L31N/lsd/README.txt

Enthält die LSD Projektdateien von Gruppe 1
