L31N/lsd/reichelt/regel.pdf

reichelt elektronik GmbH & Co. KG * Elektronikring 1 * 26452 Sande

Referenznummer: 4872969417 UNIVERSITÃ„T KARLSRUHE

76131 KARLSRUHE

reichelt elektronik GmbH & Co. KG Elektronikring 1
26452 Sande

Tel.: +49 (0)4422 955-333
Fax.: +49 (0)4422 955-111
www.reichelt.de

Datum: 02.10.2018

Online-Angebot vom 02.10.2018

Artikel-Nr. | Bezeichnung | WG Menge | Einzelpreis
incl. MwSt.

Gesamtpreis
incl. MwSt.
BS 170 | MOSFET, N-CH, 60V, 0,5A, 0,35W, TO-92 | 1 | 8 | 0,10 € | 0,80 €
D-SUB BU 09EU | D-SUB-Buchse, 9-polig, gewinkelt, RM 9,4 | 1 | 1 | 0,40 € | 0,40 €
WSL 10G | Wannenstecker, 10-polig, gerade | 1 | 2 | 0,10 € | 0,20 €
RND 135-00014 | LED, 3 mm, bedrahtet, blau, 3500 mcd, 30Â° | 1 | 8 | 0,090 € | 0,72 €
RND 135-00009 | LED, 3 mm, bedrahtet, grÃ¼n, 15000 mcd, 25Â° | 1 | 3 | 0,090 € | 0,27 €
LF33ABV | LDO-Spannungsregler 3.3 V TO-220 | 1 | 1 | 0,88 € | 0,88 €
16,0000-HC18 | Standardquarz, Grundton, 16,000000 MHz | 1 | 1 | 0,29 € | 0,29 €
1/4W 240 | Widerstand, Kohleschicht, 240 Ohm, 0207, 250 mW, 5% | 1 | 11 | 0,033 € | 0,37 €
1/4W 10K | Widerstand, Kohleschicht, 10 kOhm, 0207, 250 mW, 5% | 1 | 3 | 0,10 € | 0,31 €
X7R-5 100N | Vielschicht-Keramikkondensator 100N, 10% | 1 | 13 | 0,050 € | 0,65 €
RAD 1/63 | Elko, radial, 1,0 ÂµF, 63 V, RM 2,0, 85Â°C, 2000h, 20% | 1 | 4 | 0,020 € | 0,08 €
M-A 1000U 16 | Elko, radial, 1000 ÂµF, 16 V, RM 5, 85Â°C, 2000 h, 20% | 1 | 1 | 0,23 € | 0,23 €
KERKO-500 15P | Keramik-Kondensator, 500V, 15P | 1 | 2 | 0,070 € | 0,14 €
ATMEGA 32L8 DIP | ATMega AVR-RISC-Controller, DIL -40 | 0 | 1 | 6,25 € | 6,25 €
MAX 232 CPE | RS232-Driver, DIL-16 | 1 | 1 | 0,39 € | 0,39 €
WSL 6W | Wannenstecker, 6-polig, gewinkelt | 1 | 1 | 0,24 € | 0,24 €
WSL 14W | Wannenstecker, 14-polig, gewinkelt | 1 | 1 | 0,21 € | 0,21 €
BKL 10120182 | Stiftleiste 36 polig, vergoldet, 2,54mm | 1 | 1 | 0,50 € | 0,50 €
GS 16P | IC-Sockel, 16-polig, superflach, gedreht, vergold. | 1 | 1 | 0,23 € | 0,23 €
MPE 001-2-040-6 | PrÃ¤zisionsfassung, 40 polig, RM 2,54 | 1 | 1 | 0,86 € | 0,86 €
Warenwert | 14,02 € ============ Zuzüglich Versandkosten innerhalb Deutschlands für ca. 0,1 kg | 5,60 €

Alle Preise in Euro inklusive gesetzl. Mehrwertsteuer. Das Angebot wurde im Online-Shop durch den Benutzer selbst aus dem Warenkorb automatisch erstellt und ist freibleibend, Irrtümer und Zwischenverkauf vorbehalten. Zahlbar ohne Abzug, sofort netto Kasse. Angebotsgültigkeit 2 Werktage. Aufgrund der derzeitigen angespannten Liefersituation für Festplatten werden diese zu dem beim Bestelleingang gültigen Tagespreis ausgeliefert (siehe OnlineShop). Bitte geben Sie bei der Bestellung die o. a. Referenznummer an.

Mit freundlichen Grüßen
Ihr reichelt elektronik Team
Notebook, PC ZubehÃ¶r, Festplatte und Elektronik bei Reichelt | https://www.reichelt.de/index.html?IW=1;ACTION=515;SID=95W...
1 von 1 | 02.10.2018, 15:35
