L31N/lsd/reichelt/angebot_display.pdf

## reichelt elektronik GmbH & Co. KG * Elektronikring 1 * 26452 Sande

Referenznummer: 3936603141
UNIVERSITÃT KARLSRUHE
76131 KARLSRUHE

reichelt elektronik GmbH & Co. KG Elektronikring 1
26452 Sande

Tel.: +49 (0)4422 955-333
Fax.: +49 (0)4422 955-111
www.reichelt.de

Datum: 01.10.2018

## Online-Angebot vom 01.10.2018

Artikel-Nr. | Bezeichnung | WG | Menge | Einzelpreis incl. MwSt. | Gesamtpreis incl. MwSt.
LED EL 3-3200GE | LED, 3 mm, bedrahtet, gelb, 3200 mcd, 20° | 1 | 1 | 0,20 € | 0,20 €
LED 3-3700 BL | LED, 3 mm, bedrahtet, blau, 3700 mcd, 20° | 1 | 1 | 0,23 € | 0,23 €
LED 3-4500 RT | LED, 3 mm, bedrahtet, rot, 4500 mcd, 34° | 1 | 1 | 0,29 € | 0,29 €
16,0000-HC49U-S | Standardquarz, Grundton, 16,000000 MHz | 1 | 1 | 0,22 € | 0,22 €
LED 3-9000 GN | LED, 3 mm, bedrahtet, grün, 9000 mcd, 34° | 1 | 1 | 0,32 € | 0,32 €
KERKO 100N | Keramik-Kondensator 100N | 1 | 2 | 0,040 € | 0,08 €
KERKO 15P | Keramik-Kondensator 15P | 1 | 2 | 0,060 € | 0,12 €
PIH PT10MV103IPM | Trimmpotentiometer, 10 kOhm, linear | 1 | 1 | 0,29 € | 0,29 €
ATMEGA 8A-PU | ATMega AVR-RISC-Controller, DIL-28 | 0 | 1 | 1,40 € | 1,40 €
D-SUB BU 09EU | D-SUB-Buchse, 9-polig, gewinkelt, RM 9,4 | 1 | 1 | 0,40 € | 0,40 €
RAD 1/100 | Elko, radial, 1,0 µF, 100 V, RM 2,0, 85°C, 2000h, 20% | 1 | 4 | 0,020 € | 0,08 €
TASTER 3301B | Kurzhubtaster 6x6mm, Höhe: 9,5mm, 12V, vertikal | 1 | 8 | 0,13 € | 1,04 €
PCF 8574 AN | I2C GPIO Expander 100kHz 6V 16-Pin PDIP | 1 | 4 | 1,20 € | 4,80 €
LED 5-39000 GN | LED, 5 mm, bedrahtet, grün, 39000 mcd, 15° | 1 | 12 | 0,23 € | 2,76 €
LED 5-11000 RT | LED, 5 mm, bedrahtet, rot, 11000 mcd, 20° | 1 | 4 | 0,33 € | 1,32 €
RND 135-00030 | LED, 5 mm, bedrahtet, gelb, 20000 mcd , 15° | 1 | 8 | 0,12 € | 0,96 €
K-O SFCN1000T52 | Widerstand, Metallschicht, 100 Ohm, 0207, 0,6 W, 1% | 1 | 22 | 0,048 € | 1,05 €
K-O SFCN1002T52 | Widerstand, Metallschicht, 10 kOhm, 0207, 0,6 W, 1% | 1 | 6 | 0,080 € | 0,48 €
K-O SFCN1500T52 | Widerstand, Metallschicht, 150 Ohm, 0207, 0,6 W, 1% | 1 | 5 | 0,080 € | 0,40 €
K-O SFCN1001T52 | Widerstand, Metallschicht, 1,0 kOhm, 0207, 0,6 W, 1% | 1 | 1 | 0,080 € | 0,08 €
YAG FTE52-220R | Widerstand, Metallschicht, 220 Ohm, 0204, 0,4 W, 1% | 1 | 1 | 0,080 € | 0,08 €
K-O SFCN2201T52 | Widerstand, Metallschicht, 2,2 kOhm, 0207, 0,6 W, 1% | 1 | 1 | 0,080 € | 0,08 €
K-O SFCN47R0T52 | Widerstand, Metallschicht, 47 Ohm, 0207, 0,6 W, 1% | 1 | 1 | 0,080 € | 0,08 €
K-O SFCN4701T52 | Widerstand, Metallschicht, 4,7 kOhm, 0207, 0,6 W, 1% | 1 | 2 | 0,080 € | 0,16 €
MAX 232 CPE | RS232-Driver, DIL-16 | 1 | 1 | 0,39 € | 0,39 €
WL 2X05G 2,00 | 2x5pol. Wannen-Steckerleiste, gerade, RM 2,00 | 1 | 1 | 0,28 € | 0,28 €
Warenwert | | 17,57 €
| ============
Zuzüglich Versandkosten innerhalb Deutschlands für ca. 0,1 kg | | 5,60 €

* * *
1

Alle Preise in Euro inklusive gesetzl. Mehrwertsteuer. Das Angebot wurde im Online-Shop durch den Benutzer selbst aus dem Warenkorb automatisch erstellt und ist freibleibend, Irrtümer und Zwischenverkauf vorbehalten. Zahlbar ohne Abzug, sofort netto Kasse. Angebotsgültigkeit 2 Werktage. Aufgrund der derzeitigen angespannten Liefersituation für Festplatten werden diese zu dem beim Bestelleingang gültigen Tagespreis ausgeliefert (siehe OnlineShop). Bitte geben Sie bei der Bestellung die o. a. Referenznummer an.

Mit freundlichen Grüßen
Ihr reichelt elektronik Team

* * *
2
