L31N/lsd/concept/Konzept-Leistungsplatine.png

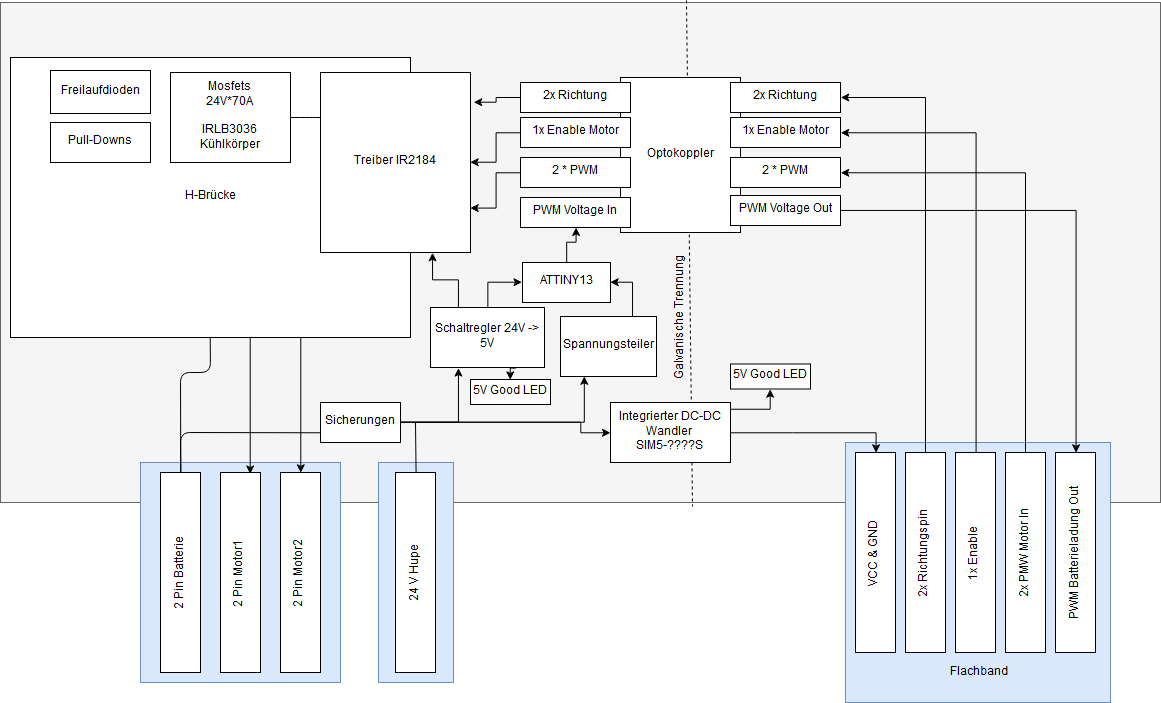
concept/Konzept-Leistungsplatine.png
