L31N/lsd/concept/Konzept-Regelungsplatine.png

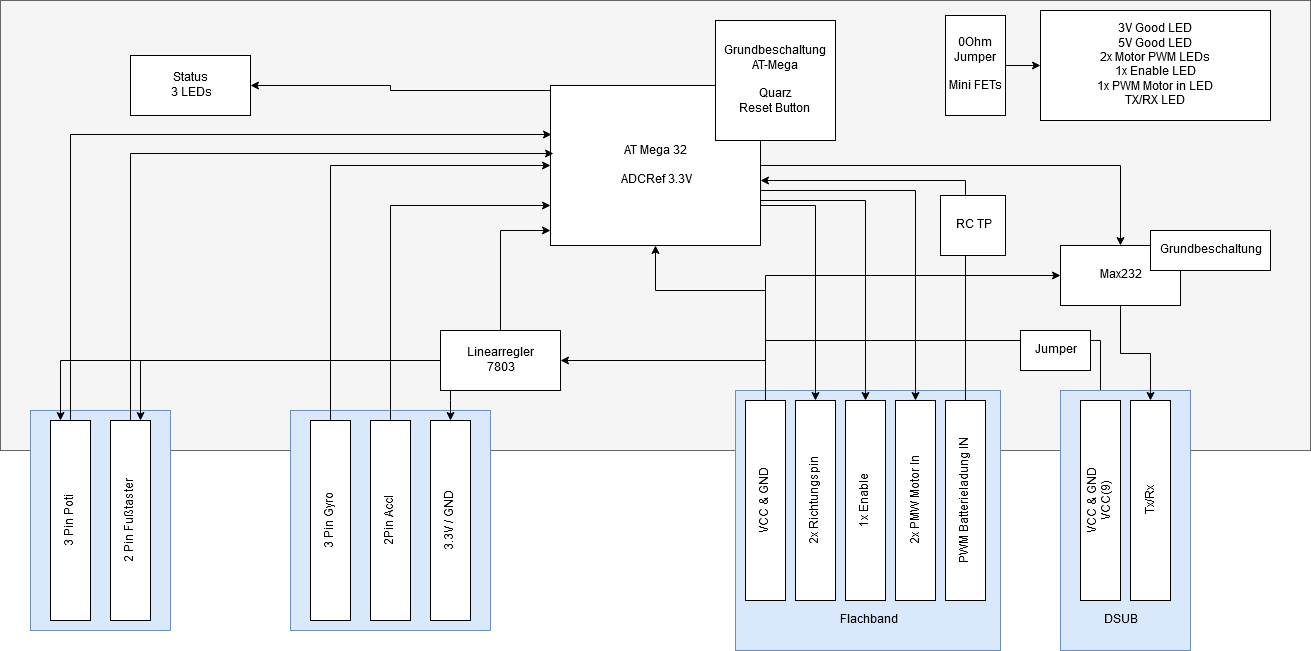
concept/Konzept-Regelungsplatine.png
