L31N/lsd/concept/Kozept-Displayplatine.png

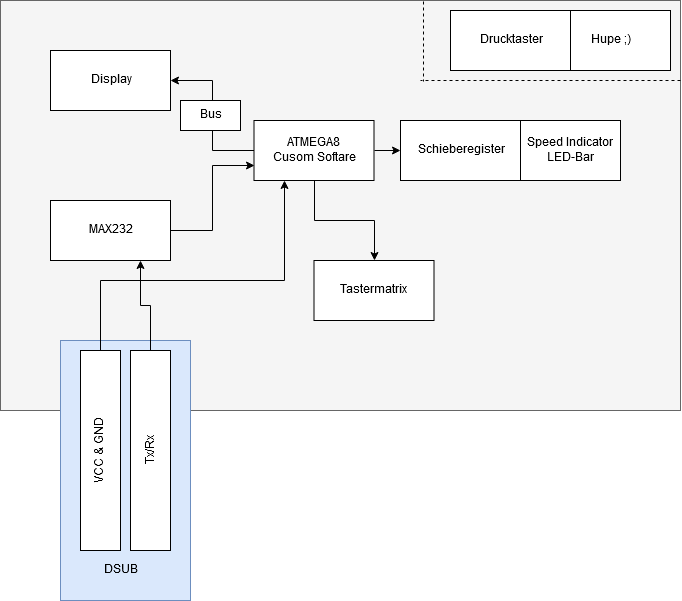
concept/Kozept-Displayplatine.png
