L31N/lsd/datasheets/LC204VL_Pins.jpg

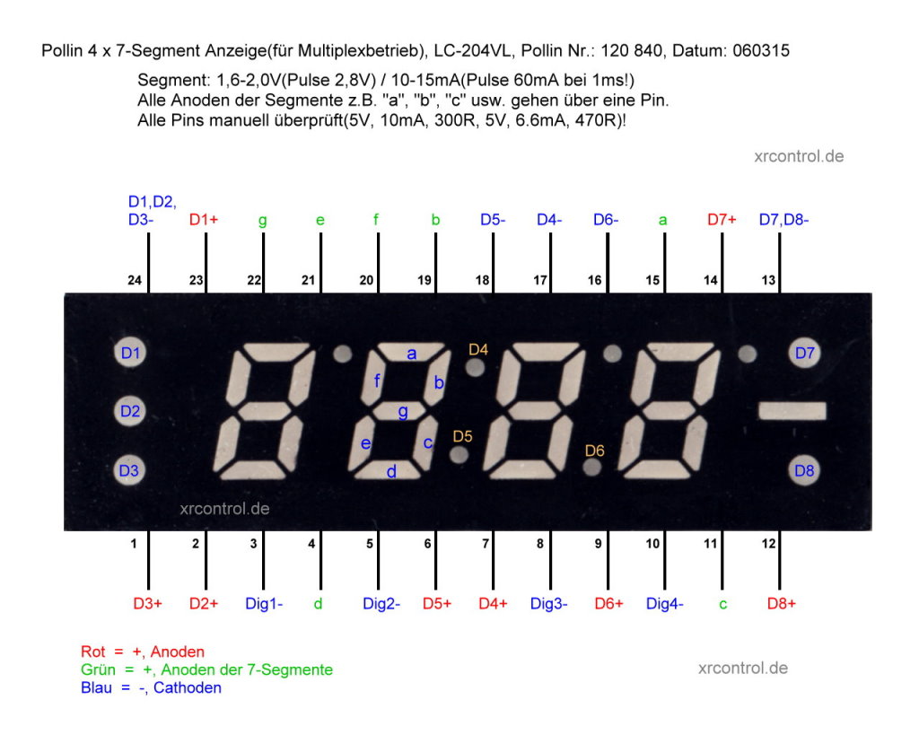
datasheets/LC204VL_Pins.jpg
