L31N/lsd/LSDTivSegG1/display.ods

Part | Value | Device | Package | Library | Sheet | Ordered | Art. Nr.
S1 | 10-XX | B3F-10XX | switch-omron | 6 |  | Y
S2 | 10-XX | B3F-10XX | switch-omron | 6 |  | Y
S3 | 10-XX | B3F-10XX | switch-omron | 6 |  | Y
S4 | 10-XX | B3F-10XX | switch-omron | 6 |  | Y
S5 | 10-XX | B3F-10XX | switch-omron | 6 |  | Y
S6 | 10-XX | B3F-10XX | switch-omron | 6 |  | Y
S7 | 10-XX | B3F-10XX | switch-omron | 6 |  | Y
S8 | 10-XX | B3F-10XX | switch-omron | 6 |  | Y
C1 | 100n | C-EU025-025X050 | C025-025X050 | rcl | 1 | Y
C8 | 100n | C-EU025-025X050 | C025-025X050 | rcl | 1 | Y
R12 | 100R | R-EU_0207/10 | 0207/10 | rcl | 5 | Y
R13 | 100R | R-EU_0207/10 | 0207/10 | rcl | 5 | Y
R14 | 100R | R-EU_0207/10 | 0207/10 | rcl | 5 | Y
R15 | 100R | R-EU_0207/10 | 0207/10 | rcl | 5 | Y
R16 | 100R | R-EU_0207/10 | 0207/10 | rcl | 5 | Y
R17 | 100R | R-EU_0207/10 | 0207/10 | rcl | 5 | Y
R18 | 100R | R-EU_0207/10 | 0207/10 | rcl | 5 | Y
R19 | 100R | R-EU_0207/10 | 0207/10 | rcl | 5 | Y
R20 | 100R | R-EU_0207/10 | 0207/10 | rcl | 5 | Y
R21 | 100R | R-EU_0207/10 | 0207/10 | rcl | 5 | Y
R24 | 100R | R-EU_0207/10 | 0207/10 | rcl | 5 | Y
R25 | 100R | R-EU_0207/10 | 0207/10 | rcl | 5 | Y
R26 | 100R | R-EU_0207/10 | 0207/10 | rcl | 5 | Y
R27 | 100R | R-EU_0207/10 | 0207/10 | rcl | 5 | Y
R28 | 100R | R-EU_0207/10 | 0207/10 | rcl | 5 | Y
R29 | 100R | R-EU_0207/10 | 0207/10 | rcl | 5 | Y
R30 | 100R | R-EU_0207/10 | 0207/10 | rcl | 5 | Y
R31 | 100R | R-EU_0207/10 | 0207/10 | rcl | 5 | Y
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
LED21 | yellow | LED5MM | LED5MM | led | 5 | Y
LED22 | yellow | LED5MM | LED5MM | led | 5 | Y
LED27 | yellow | LED3MM | LED3MM | led | 1 | Y
LED7 | yellow | LED5MM | LED5MM | led | 5 | Y
LED8 | yellow | LED5MM | LED5MM | led | 5 | Y
LED9 | yellow | LED5MM | LED5MM | led | 5 | Y
