L31N/lsd/LSDTivSegG1/leistung.pdf

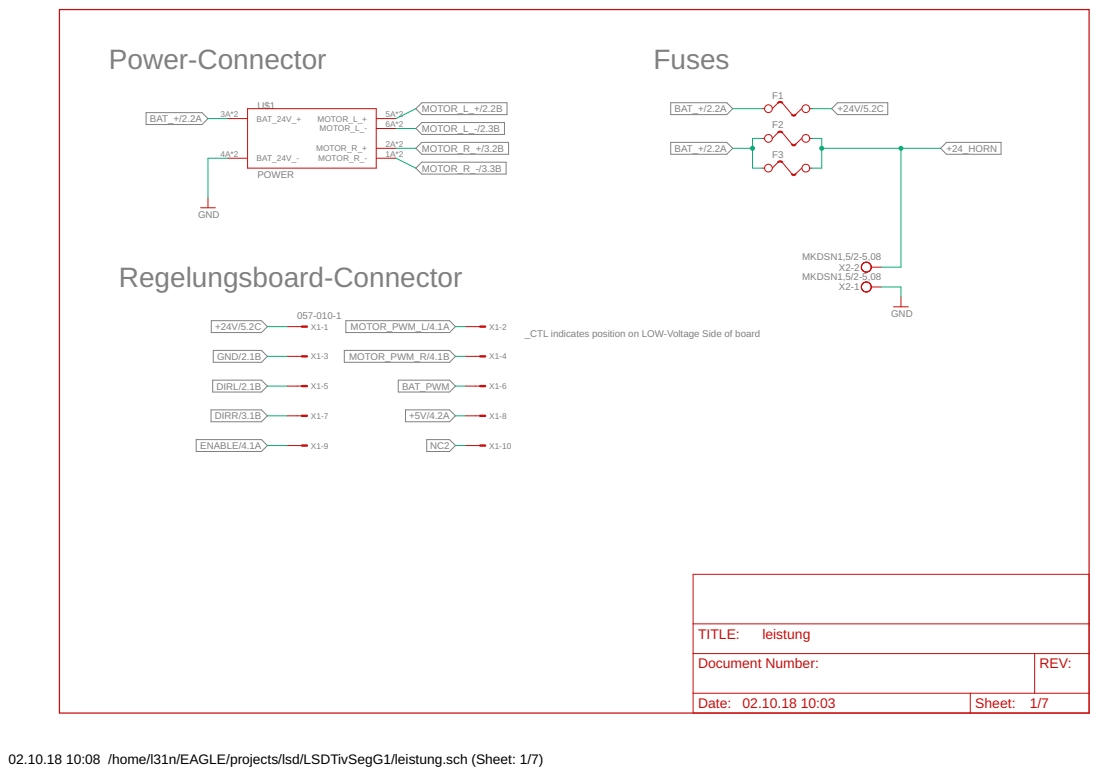
[picture p5: page 1]

_CTL indicates position on LOW-Voltage Side of board

Document Number: | REV:

Date: 02.10.18 10:03 | Sheet: 1/7

02.10.18 10:08 /home/l31n/EAGLE/projects/lsd/LSDTivSegG1/leistung.sch (Sheet: 1/7)

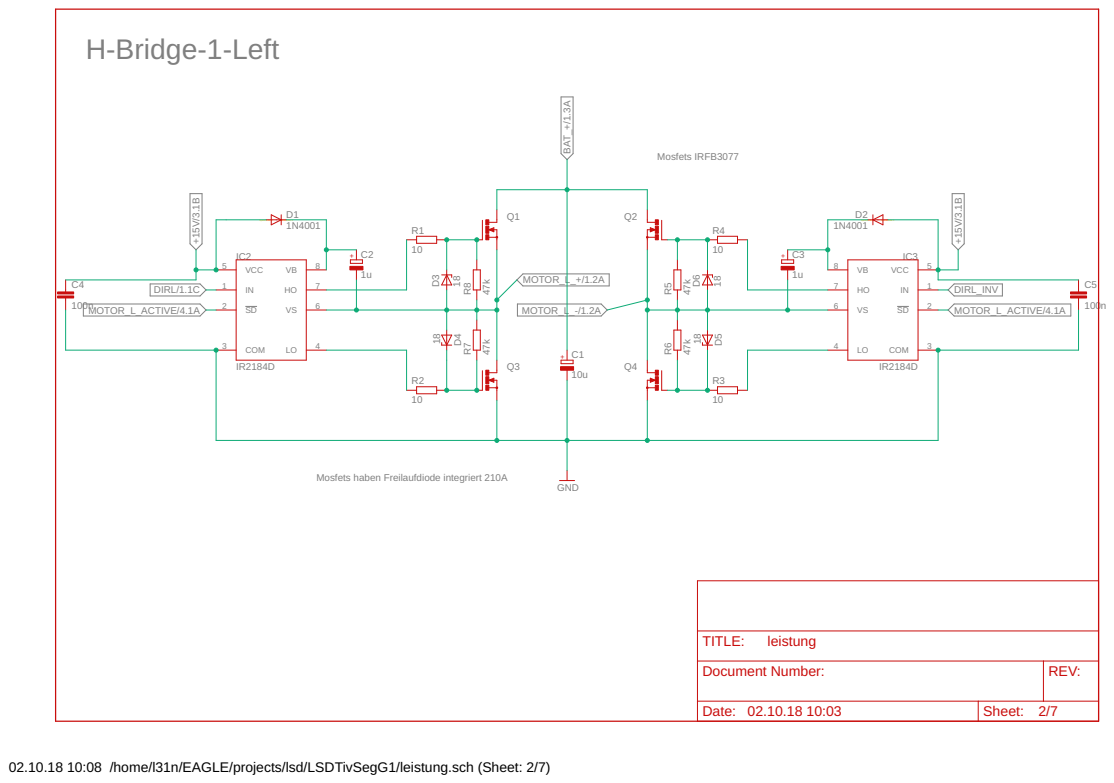
[picture p6: page 2]

Mosfets haben Freilaufdiode integriert 210A

Document Number: | REV:

Date: 02.10.18 10:03 | Sheet: 2/7

02.10.18 10:08 /home/l31n/EAGLE/projects/lsd/LSDTivSegG1/leistung.sch (Sheet: 2/7)

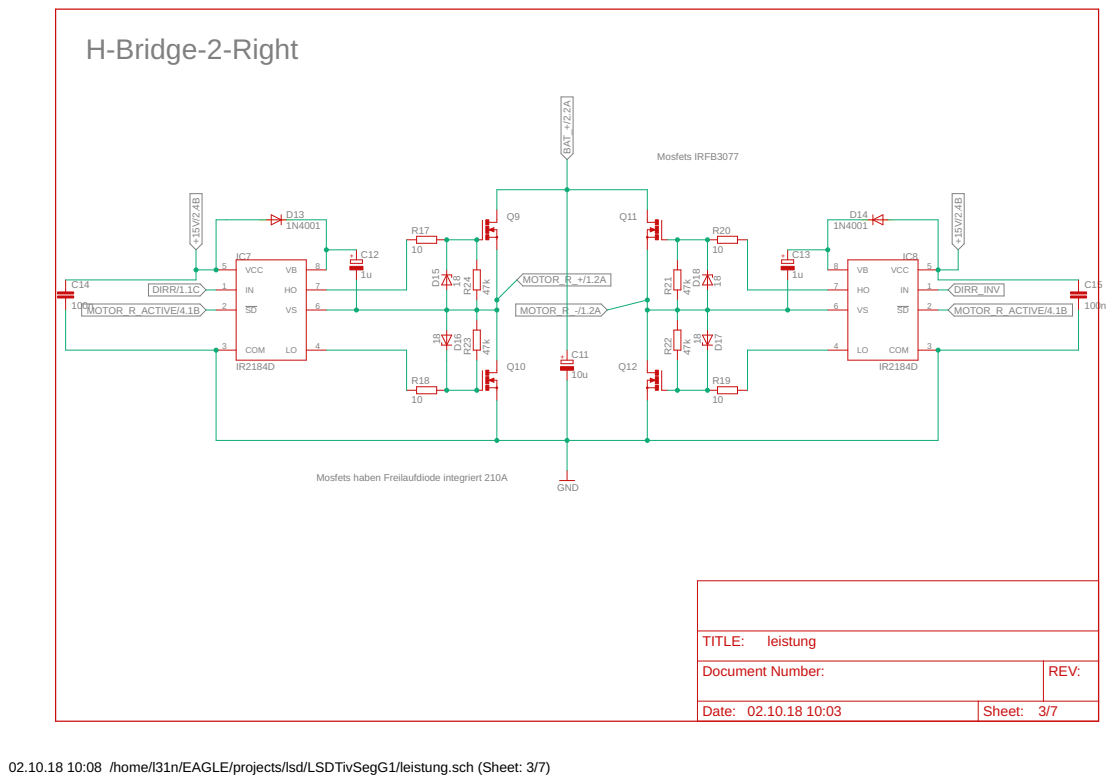
[picture p7: page 3]

Mosfets haben Freilaufdiode integriert 210A

Document Number: | REV:

Date: 02.10.18 10:03 | Sheet: 3/7

02.10.18 10:08 /home/l31n/EAGLE/projects/lsd/LSDTivSegG1/leistung.sch (Sheet: 3/7)

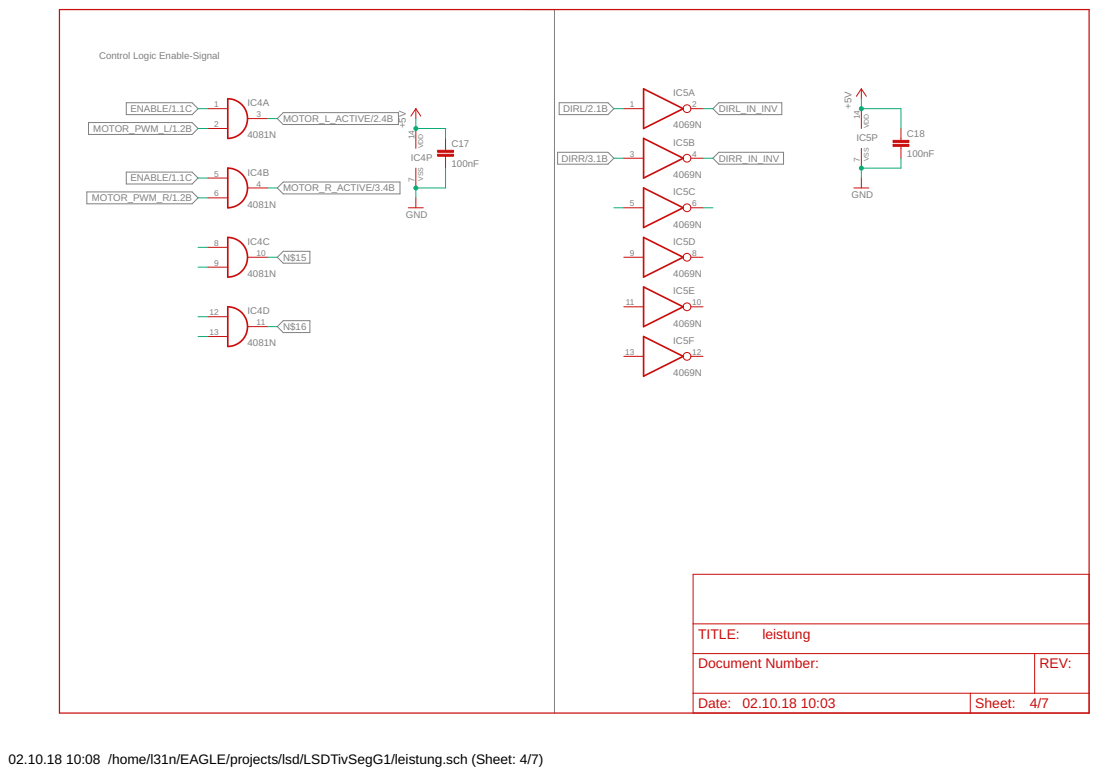
[picture p8: page 4]

Control Logic Enable-Signal

Document Number: | REV:

Date: 02.10.18 10:03 | Sheet: 4/7

02.10.18 10:08 /home/l31n/EAGLE/projects/lsd/LSDTivSegG1/leistung.sch (Sheet: 4/7)

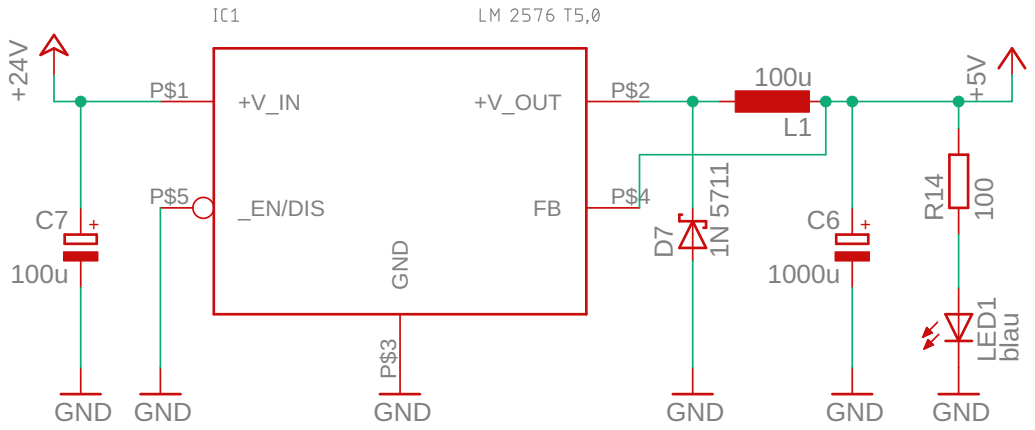
[picture p9: page 5]

02.10.18 10:08 f=0.91 /home/l31n/EAGLE/projects/lsd/LSDTivSegG1/leistung.sch (Sheet: 5/7)

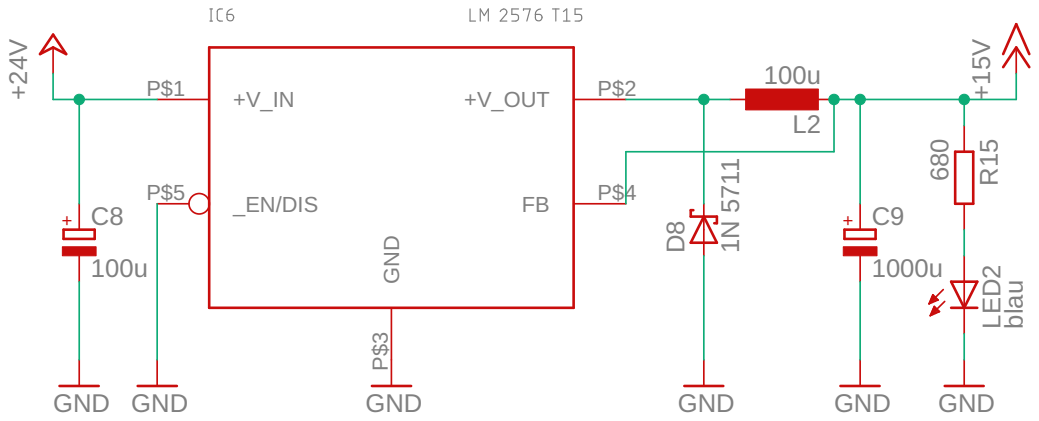
[picture p10: page 6]

02.10.18 10:08 f=0.91 /home/l31n/EAGLE/projects/lsd/LSDTivSegG1/leistung.sch (Sheet: 6/7)

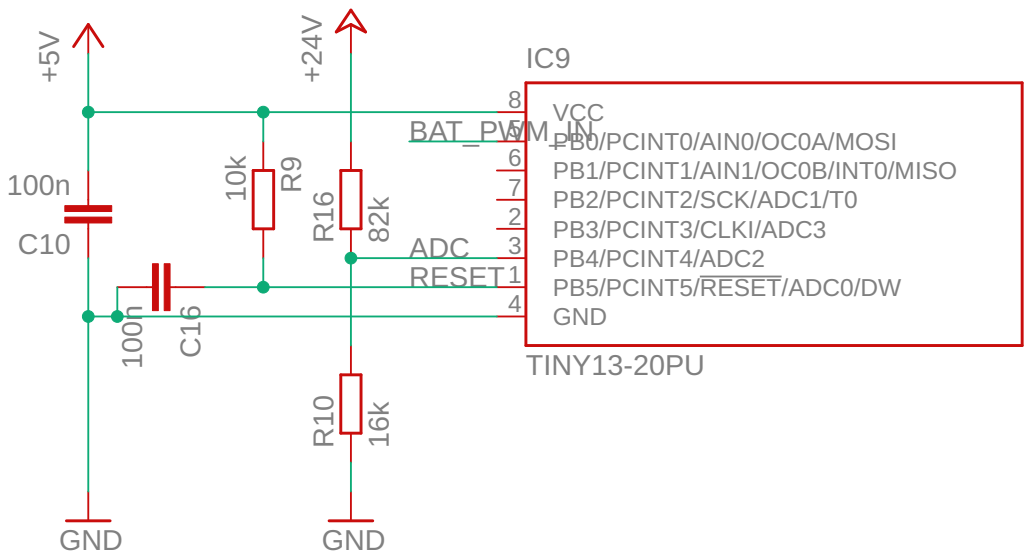
[picture p11: page 7]

02.10.18 10:08 f=0.91 /home/l31n/EAGLE/projects/lsd/LSDTivSegG1/leistung.sch (Sheet: 7/7)
