L31N/lsd/LSDTivSegG1/display_brd_bottom.pdf

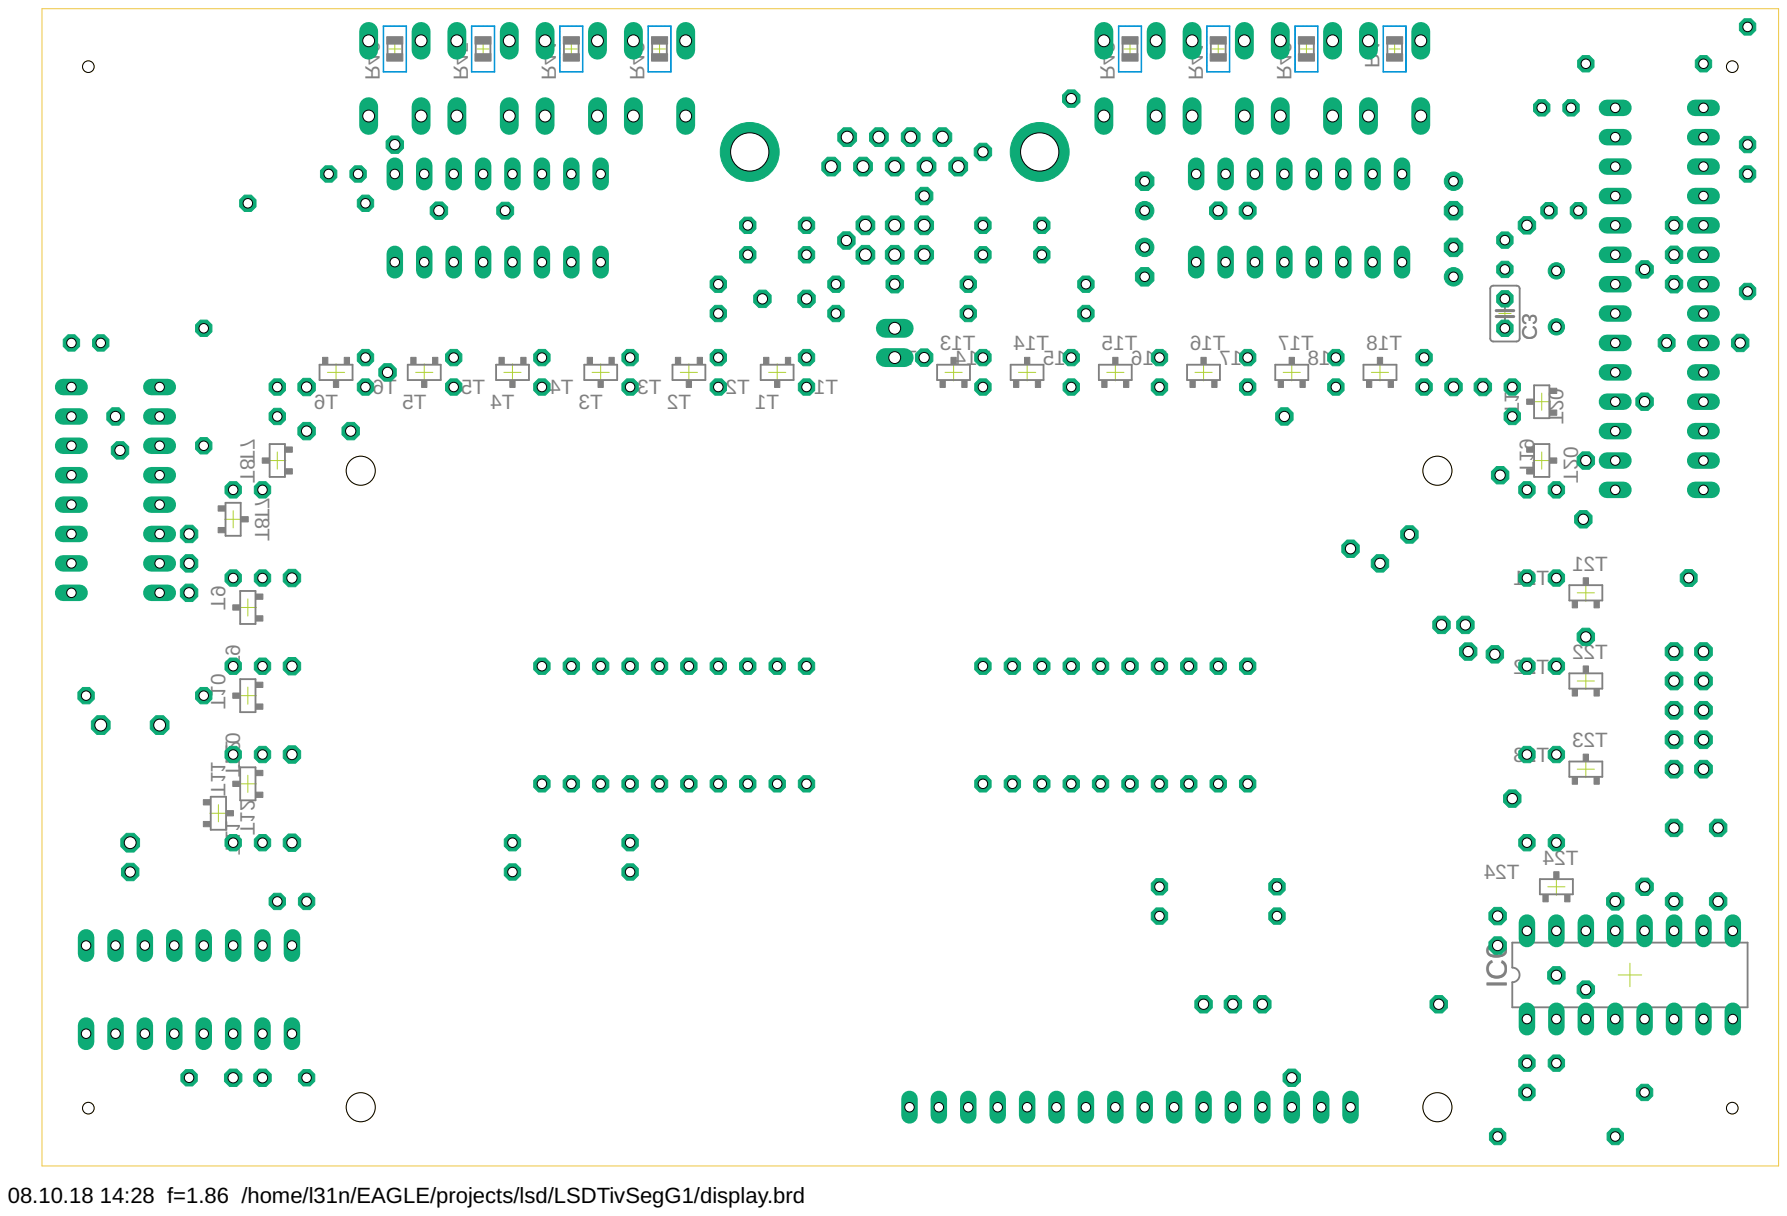
[picture p12: page 1]

08.10.18 14:28 f=1.86 /home/l31n/EAGLE/projects/lsd/LSDTivSegG1/display.brd
