L31N/lsd/LSDTivSegG1/display.pdf

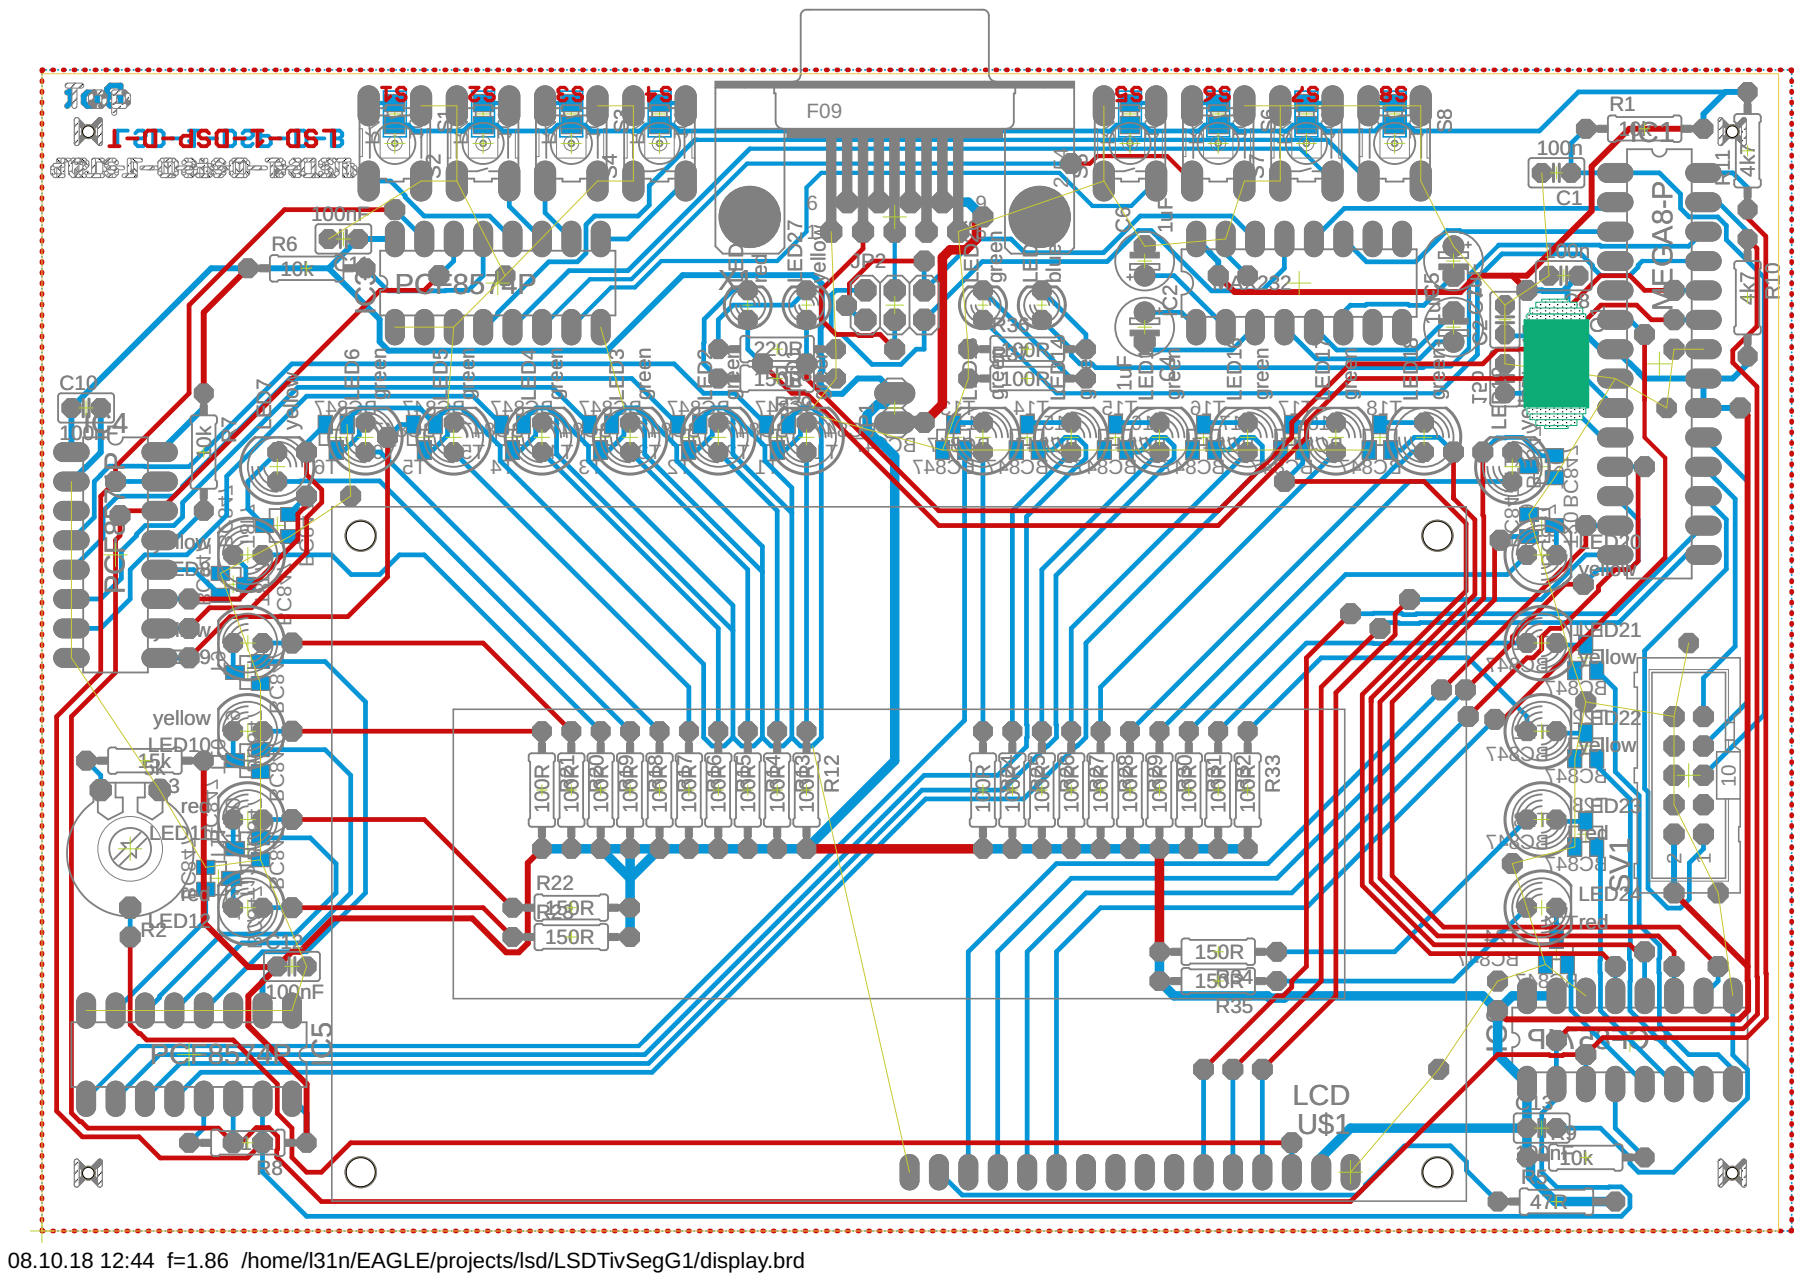
[picture p14: page 1]

08.10.18 12:44 f=1.86 /home/l31n/EAGLE/projects/lsd/LSDTivSegG1/display.brd
