L31N/lsd/LSDTivSegG1/regelschaltplan.pdf

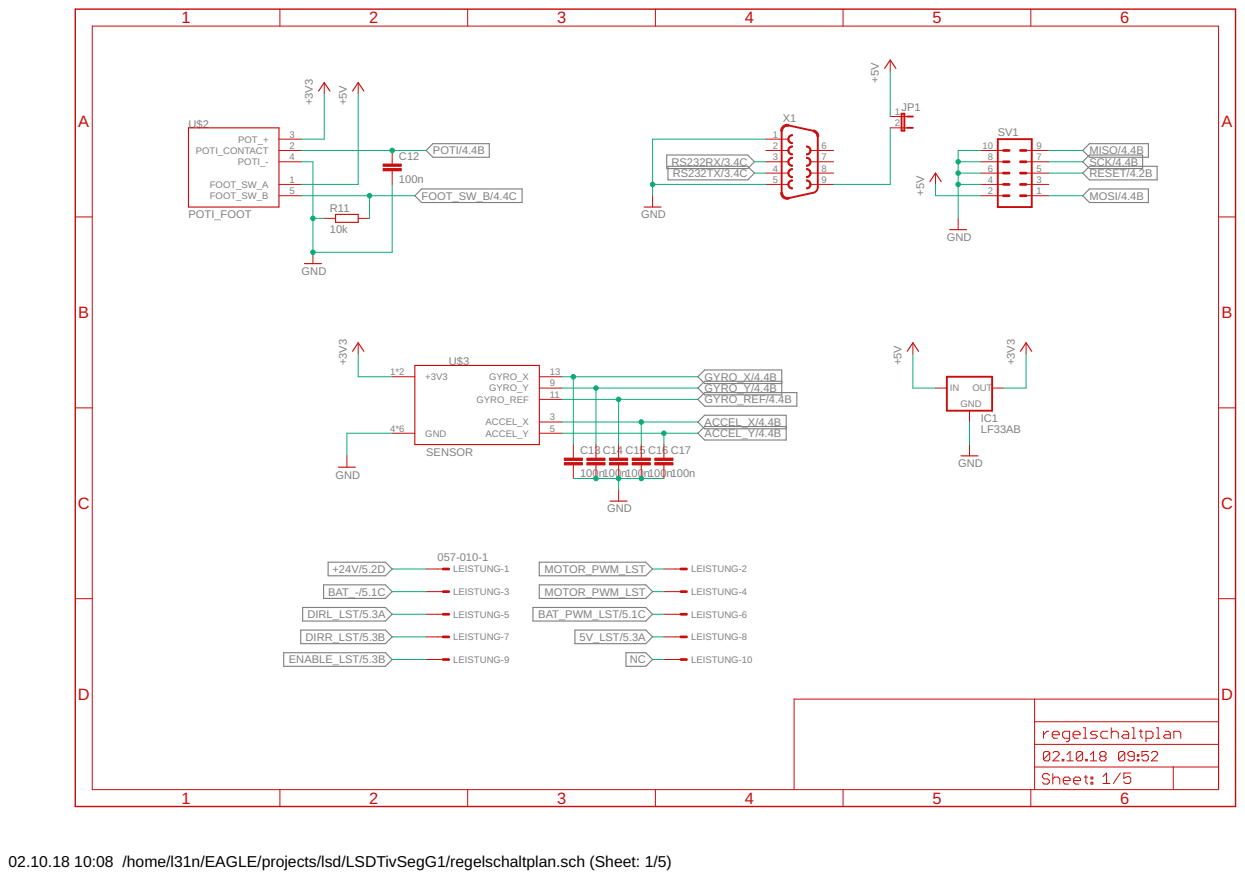
[picture p15: page 1]

02.10.18 10:08 /home/l31n/EAGLE/projects/lsd/LSDTivSegG1/regelschaltplan.sch (Sheet: 1/5)

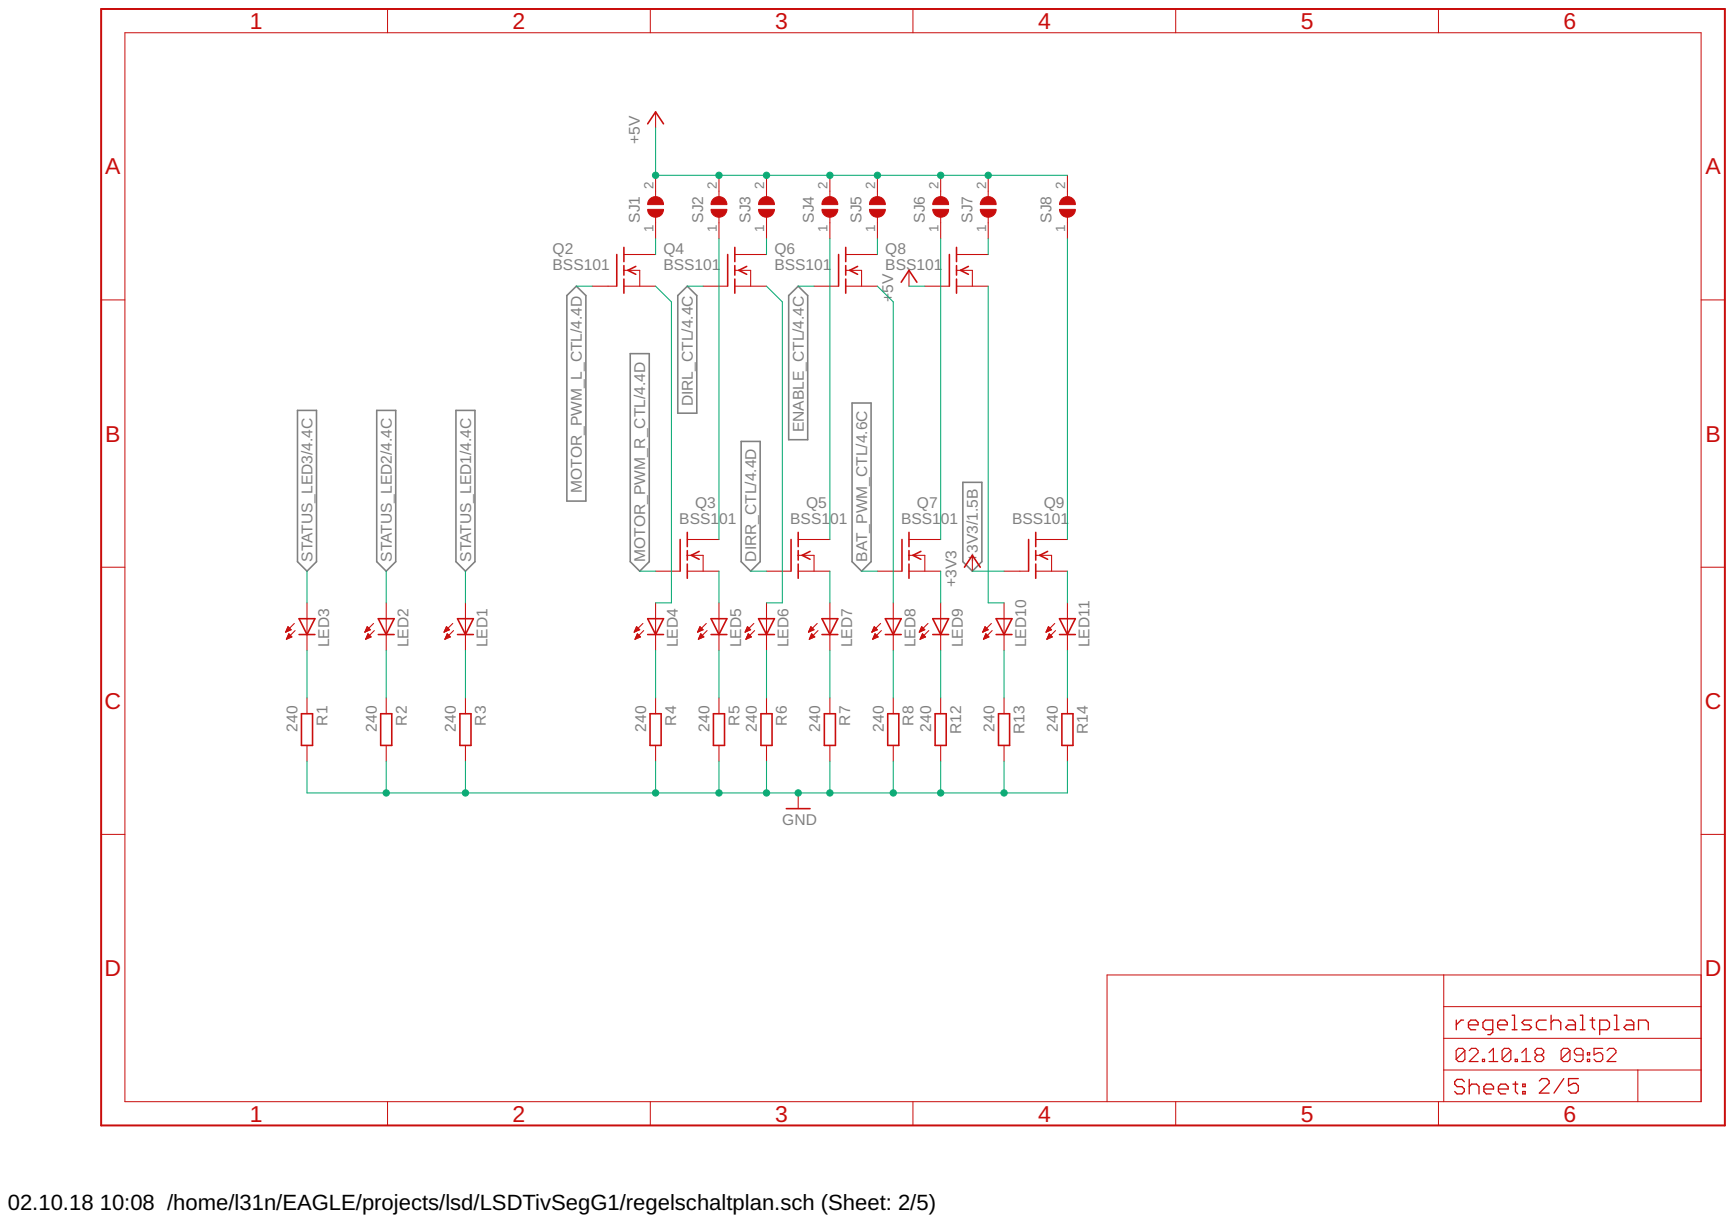
[picture p16: page 2]

02.10.18 10:08 /home/l31n/EAGLE/projects/lsd/LSDTivSegG1/regelschaltplan.sch (Sheet: 2/5)

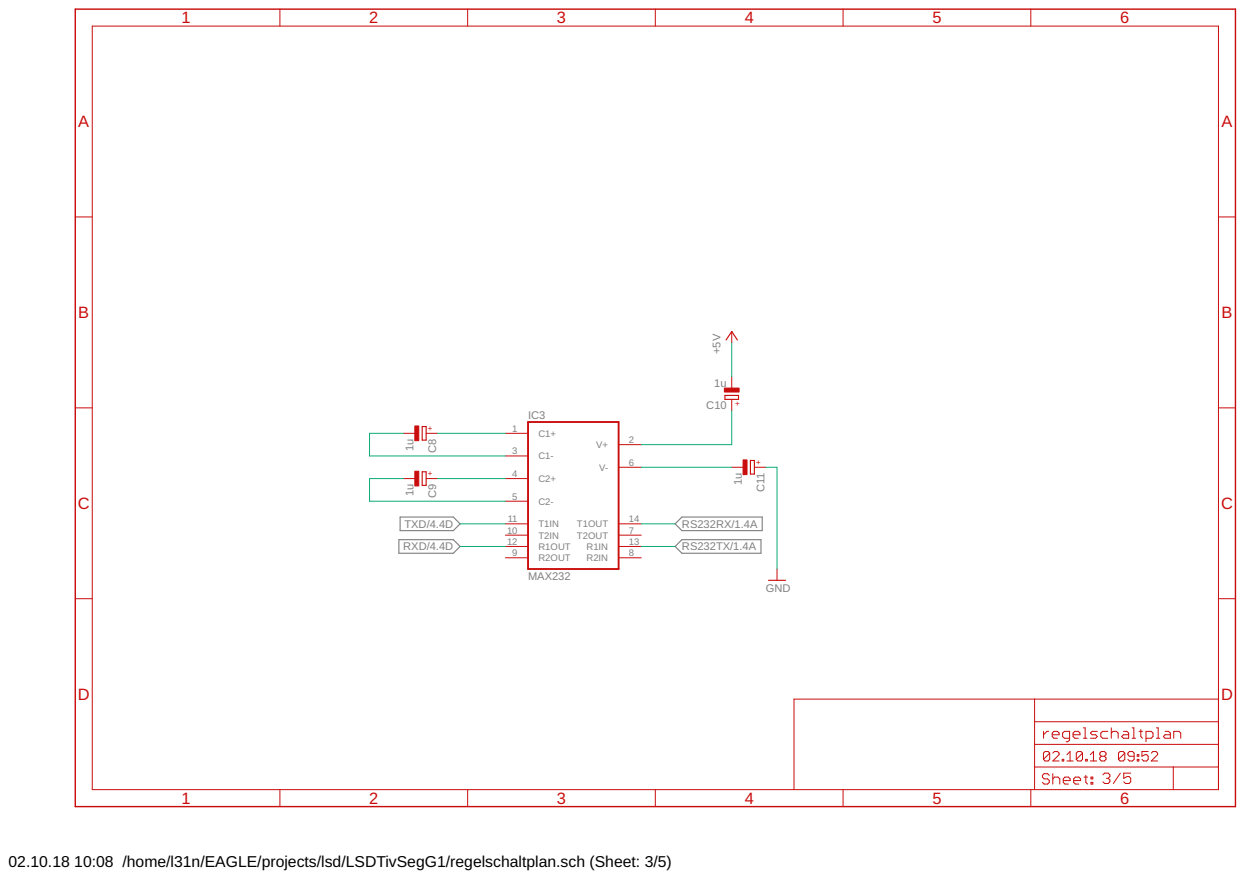
[picture p17: page 3]

02.10.18 10:08 /home/l31n/EAGLE/projects/lsd/LSDTivSegG1/regelschaltplan.sch (Sheet: 3/5)

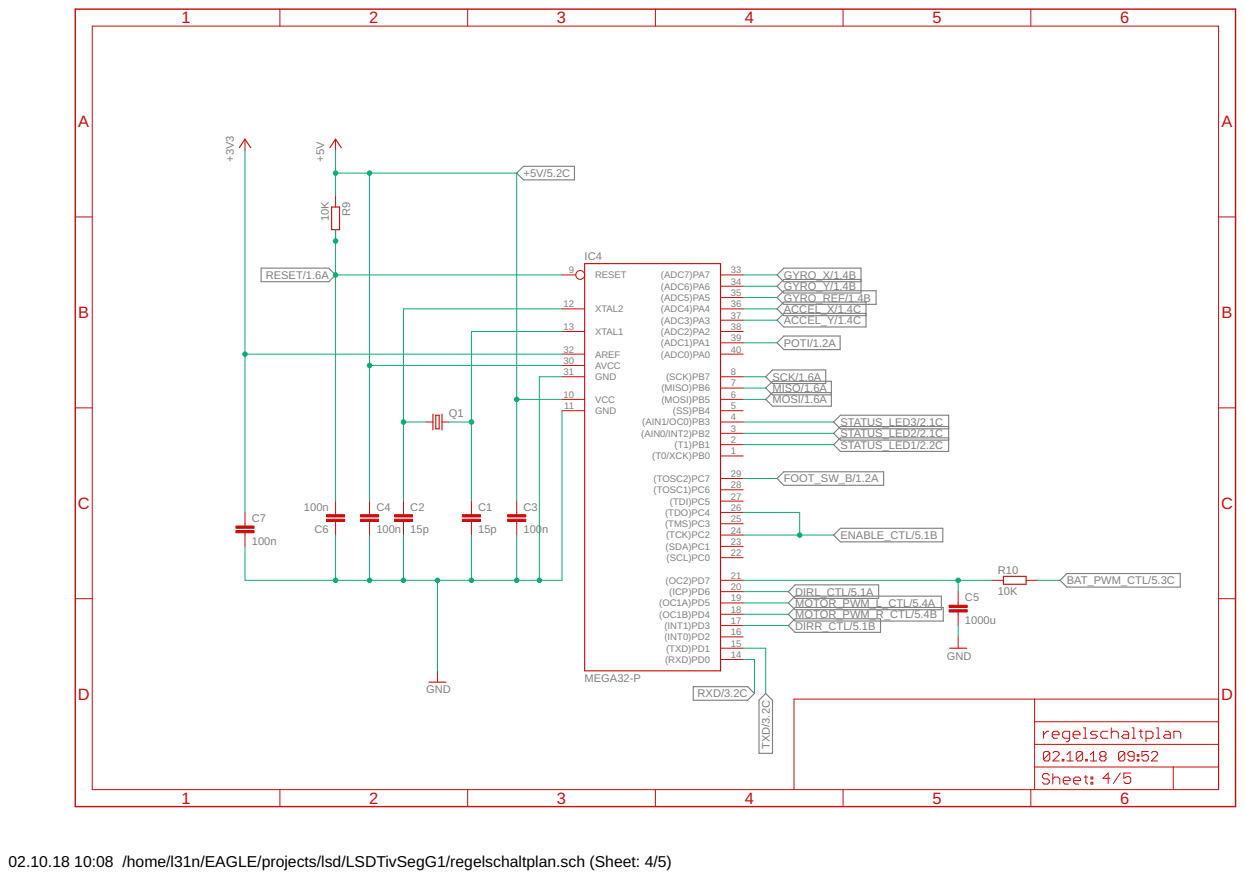
[picture p18: page 4]

02.10.18 10:08 /home/l31n/EAGLE/projects/lsd/LSDTivSegG1/regelschaltplan.sch (Sheet: 4/5)

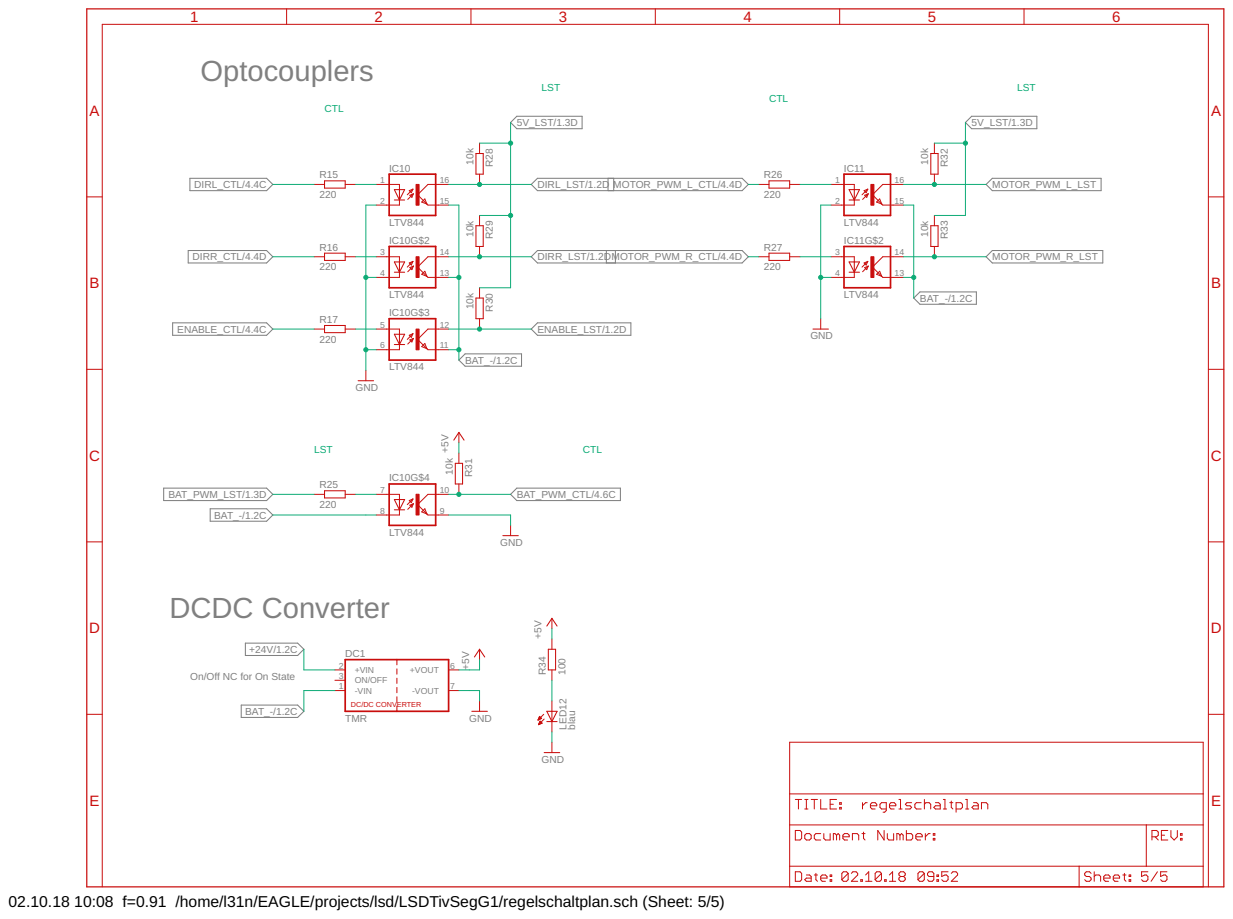
[picture p19: page 5]

On/Off NC for On State

02.10.18 10:08 f=0.91 /home/l31n/EAGLE/projects/lsd/LSDTivSegG1/regelschaltplan.sch (Sheet: 5/5)
