L31N/lsd/LSDTivSegG1/regelschaltplan_e7.brd

## EAGLE design LSDTivSegG1/regelschaltplan_e7.brd (2018-10-08)

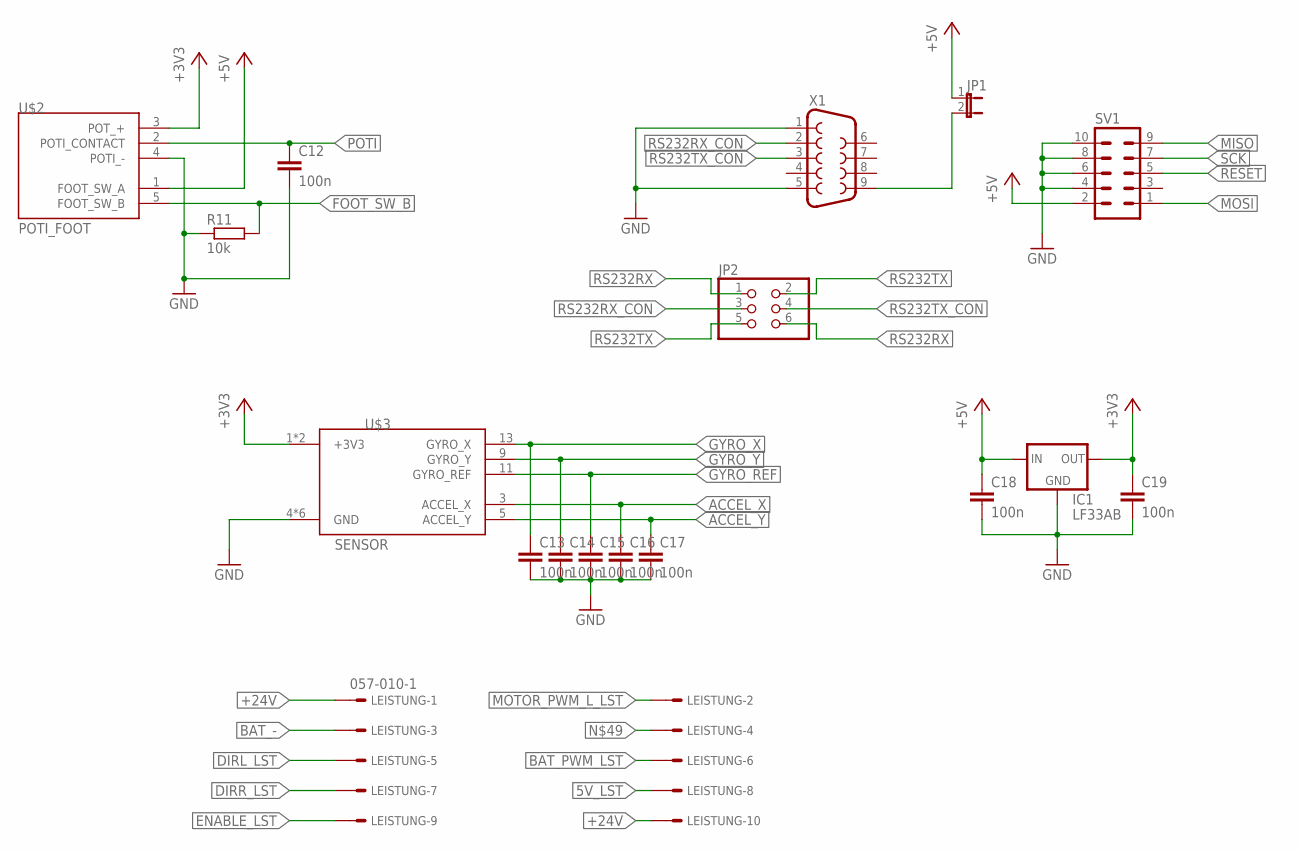
[picture p20: schematic regelschaltplan_e7.sch, sheet 1]

Parts:
C12, C13, C14, C15, C16, C17, C18, C19: 100n; C025-025X050
IC1: LF33AB; TO220
JP1: JP1E; JP1
JP2: PINHD-2X3; 2X03
LEISTUNG: 057-010-1
R11: 10k; 0207/7
SV1: MA05-2
U$2: POTI_FOOT; CON_6
U$3: SENSOR; CON_14
X1: F09HP

Connections:
5V_LST: LEISTUNG.8; also elsewhere on the board
+3V3: C19.1, IC1.3 (OUT), U$2.3 (POT_+), U$3.1 (+3V3), U$3.2 (+3V3); also elsewhere on the board
+24V: LEISTUNG.1, LEISTUNG.10; also elsewhere on the board
ACCEL_X: C16.1, U$3.3 (ACCEL_X); also elsewhere on the board
ACCEL_Y: C17.1, U$3.5 (ACCEL_Y); also elsewhere on the board
BAT_-: LEISTUNG.3; also elsewhere on the board
BAT_PWM_LST: LEISTUNG.6; also elsewhere on the board
DIRL_LST: LEISTUNG.5; also elsewhere on the board
DIRR_LST: LEISTUNG.7; also elsewhere on the board
ENABLE_LST: LEISTUNG.9; also elsewhere on the board
FOOT_SW_B: R11.2, U$2.5 (FOOT_SW_B); also elsewhere on the board
GND: C12.2, C13.2, C14.2, C15.2, C16.2, C17.2, C18.2, C19.2, IC1.2 (GND), R11.1, SV1.4, SV1.6, SV1.8, SV1.10, U$2.4 (POTI_-), U$3.4 (GND), U$3.6 (GND), U$3.8 (GND), U$3.10 (GND), U$3.12 (GND), U$3.14 (GND), X1.1, X1.5; also elsewhere on the board
GYRO_REF: C15.1, U$3.11 (GYRO_REF); also elsewhere on the board
GYRO_X: C13.1, U$3.13 (GYRO_X); also elsewhere on the board
GYRO_Y: C14.1, U$3.9 (GYRO_Y); also elsewhere on the board
MISO: SV1.9; also elsewhere on the board
MOSI: SV1.1; also elsewhere on the board
MOTOR_PWM_L_LST: LEISTUNG.2; also elsewhere on the board
unnamed 58: C18.1, IC1.1 (IN), JP1.1, SV1.2, U$2.1 (FOOT_SW_A); also elsewhere on the board
unnamed: JP1.2, X1.9
unnamed 71: LEISTUNG.4; also elsewhere on the board
POTI: C12.1, U$2.2 (POTI_CONTACT); also elsewhere on the board
RESET: SV1.5; also elsewhere on the board
RS232RX: JP2.1, JP2.6; also elsewhere on the board
RS232RX_CON: JP2.3, X1.2
RS232TX: JP2.2, JP2.5; also elsewhere on the board
RS232TX_CON: JP2.4, X1.3
SCK: SV1.7; also elsewhere on the board

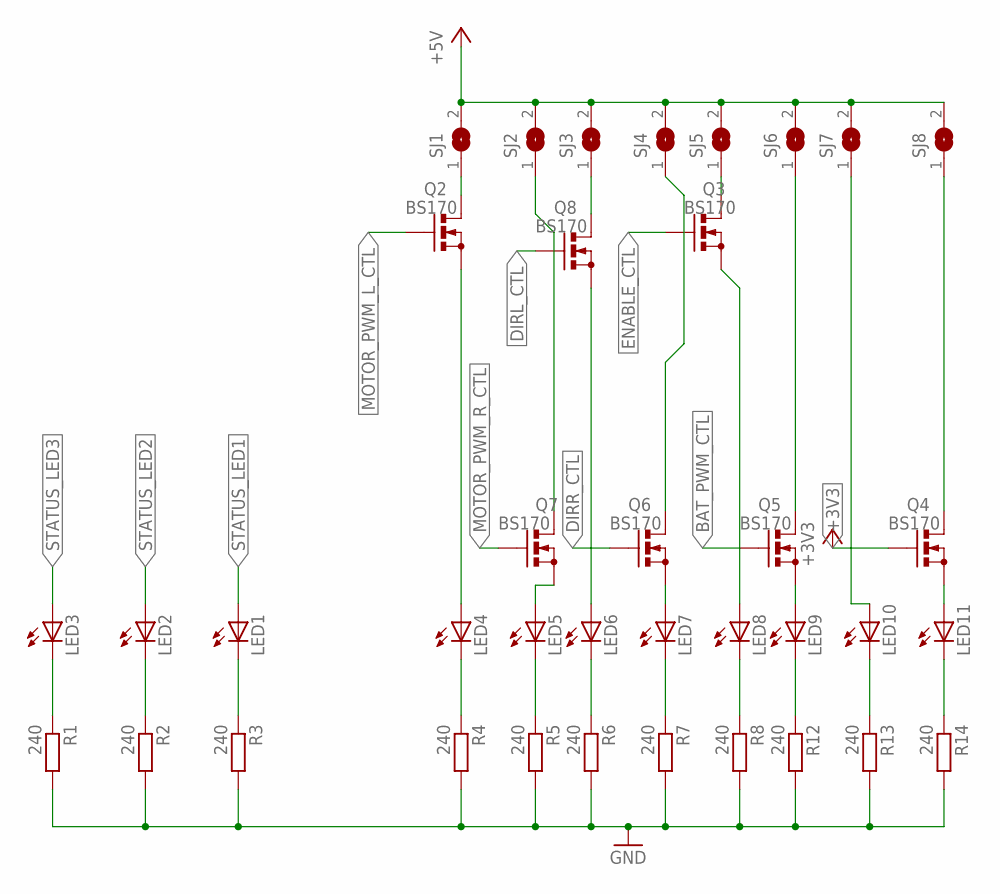
[picture p21: schematic regelschaltplan_e7.sch, sheet 2]

Parts:
LED1, LED2, LED3, LED4, LED5, LED6, LED7, LED8, LED9, LED10, LED11: LED3MM
Q2, Q3, Q4, Q5, Q6, Q7, Q8: BS170; SOT54E
R1, R2, R3, R4, R5, R6, R7, R8, R12, R13, R14: 240; 0207/7
SJ1, SJ2, SJ3, SJ4, SJ5, SJ6, SJ7, SJ8: SJ

Connections:
+3V3: Q4.G; also elsewhere on the board
BAT_PWM_CTL: Q5.G; also elsewhere on the board
DIRL_CTL: Q8.G; also elsewhere on the board
DIRR_CTL: Q6.G; also elsewhere on the board
ENABLE_CTL: Q3.G; also elsewhere on the board
GND: R1.2, R2.2, R3.2, R4.2, R5.2, R6.2, R7.2, R8.2, R12.2, R13.2, R14.2; also elsewhere on the board
MOTOR_PWM_L_CTL: Q2.G; also elsewhere on the board
MOTOR_PWM_R_CTL: Q7.G; also elsewhere on the board
unnamed: Q2.D, SJ1.1
unnamed: LED4.K (C), R4.1
unnamed: LED5.K (C), R5.1
unnamed: LED6.K (C), R6.1
unnamed: LED6.A, Q8.S
unnamed: LED7.K (C), R7.1
unnamed: LED8.K (C), R8.1
unnamed: LED9.K (C), R12.1
unnamed: LED10.K (C), R13.1
unnamed: LED11.K (C), R14.1
unnamed: LED8.A, Q3.S
unnamed: LED10.A, SJ7.1
unnamed: LED9.A, Q5.S
unnamed: Q4.D, SJ8.1
unnamed: LED7.A, Q6.S
unnamed: LED5.A, Q7.S
unnamed: Q7.D, SJ2.1
unnamed: LED4.A, Q2.S
unnamed: LED11.A, Q4.S
unnamed: LED2.K (C), R2.1
unnamed: LED3.K (C), R1.1
unnamed: Q6.D, SJ4.1
unnamed: Q5.D, SJ6.1
unnamed: Q3.D, SJ5.1
unnamed: Q8.D, SJ3.1
unnamed 58: SJ1.2, SJ2.2, SJ3.2, SJ4.2, SJ5.2, SJ6.2, SJ7.2, SJ8.2; also elsewhere on the board
unnamed: LED1.K (C), R3.1
STATUS_LED1: LED1.A; also elsewhere on the board
STATUS_LED2: LED2.A; also elsewhere on the board
STATUS_LED3: LED3.A; also elsewhere on the board

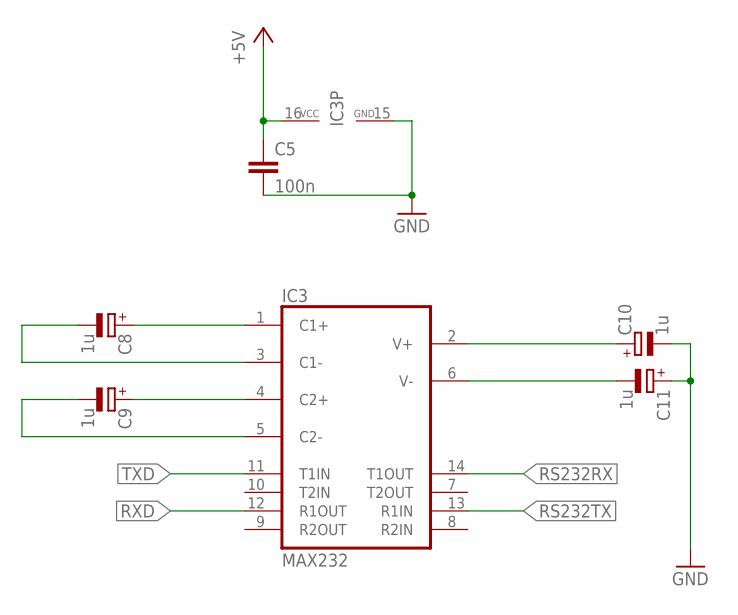
[picture p22: schematic regelschaltplan_e7.sch, sheet 3]

Parts:
C5: 100n; C025-025X050
C8, C9, C10, C11: 1u; E2,5-6E
IC3: MAX232; DIL16

Connections:
GND: C5.2, C10.-, C11.+, IC3.15 (GND); also elsewhere on the board
unnamed: C8.+, IC3.1 (C1+)
unnamed: C8.-, IC3.3 (C1-)
unnamed: C9.+, IC3.4 (C2+)
unnamed: C10.+, IC3.2 (V+)
unnamed: C11.-, IC3.6 (V-)
unnamed 58: C5.1, IC3.16 (VCC); also elsewhere on the board
NS1234: C9.-, IC3.5 (C2-)
RS232RX: IC3.14 (T1OUT); also elsewhere on the board
RS232TX: IC3.13 (R1IN); also elsewhere on the board
RXD: IC3.12 (R1OUT); also elsewhere on the board
TXD: IC3.11 (T1IN); also elsewhere on the board

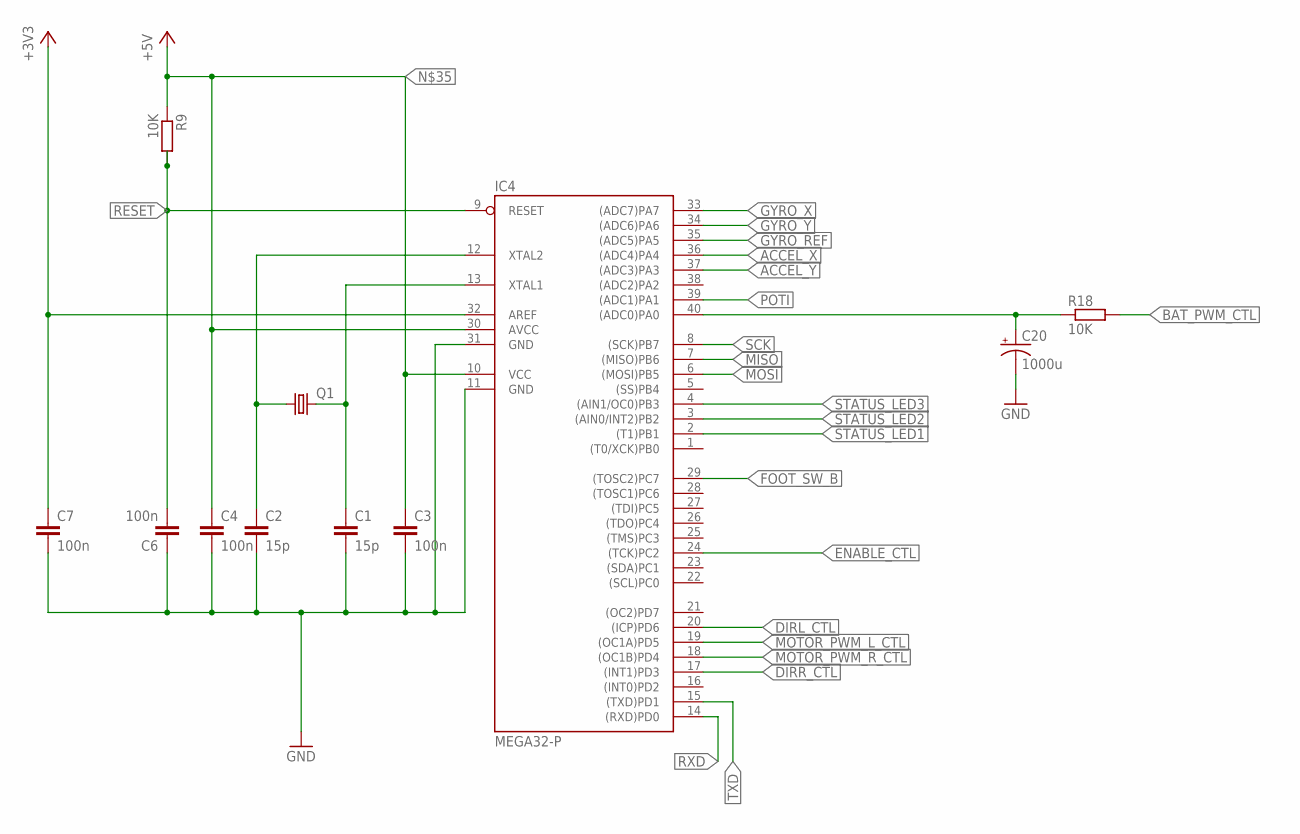
[picture p23: schematic regelschaltplan_e7.sch, sheet 4]

Parts:
C1, C2: 15p; C025-025X050
C3, C4, C6, C7: 100n; C025-025X050
C20: 1000u; E2,5-6E
IC4: MEGA32-P; DIL40
Q1: CRYSTALHC49U-V; HC49U-V
R9, R18: 10K; 0207/7

Connections:
+3V3: C7.1, IC4.32 (AREF); also elsewhere on the board
ACCEL_X: IC4.36 ((ADC4)PA4); also elsewhere on the board
ACCEL_Y: IC4.37 ((ADC3)PA3); also elsewhere on the board
BAT_PWM_CTL: R18.2; also elsewhere on the board
DIRL_CTL: IC4.20 ((ICP)PD6); also elsewhere on the board
DIRR_CTL: IC4.17 ((INT1)PD3); also elsewhere on the board
ENABLE_CTL: IC4.24 ((TCK)PC2); also elsewhere on the board
FOOT_SW_B: IC4.29 ((TOSC2)PC7); also elsewhere on the board
GND: C1.2, C2.2, C3.2, C4.2, C6.1, C7.2, C20.-, IC4.11 (GND), IC4.31 (GND); also elsewhere on the board
GYRO_REF: IC4.35 ((ADC5)PA5); also elsewhere on the board
GYRO_X: IC4.33 ((ADC7)PA7); also elsewhere on the board
GYRO_Y: IC4.34 ((ADC6)PA6); also elsewhere on the board
MISO: IC4.7 ((MISO)PB6); also elsewhere on the board
MOSI: IC4.6 ((MOSI)PB5); also elsewhere on the board
MOTOR_PWM_L_CTL: IC4.19 ((OC1A)PD5); also elsewhere on the board
MOTOR_PWM_R_CTL: IC4.18 ((OC1B)PD4); also elsewhere on the board
unnamed: C2.1, IC4.12 (XTAL2), Q1.1
unnamed: C1.1, IC4.13 (XTAL1), Q1.2
unnamed: C20.+, IC4.40 ((ADC0)PA0), R18.1
unnamed 58: C3.1, C4.1, IC4.10 (VCC), IC4.30 (AVCC), R9.1; also elsewhere on the board
POTI: IC4.39 ((ADC1)PA1); also elsewhere on the board
RESET: C6.2, IC4.9 (RESET), R9.2; also elsewhere on the board
RXD: IC4.14 ((RXD)PD0); also elsewhere on the board
SCK: IC4.8 ((SCK)PB7); also elsewhere on the board
STATUS_LED1: IC4.2 ((T1)PB1); also elsewhere on the board
STATUS_LED2: IC4.3 ((AIN0/INT2)PB2); also elsewhere on the board
STATUS_LED3: IC4.4 ((AIN1/OC0)PB3); also elsewhere on the board
TXD: IC4.15 ((TXD)PD1); also elsewhere on the board

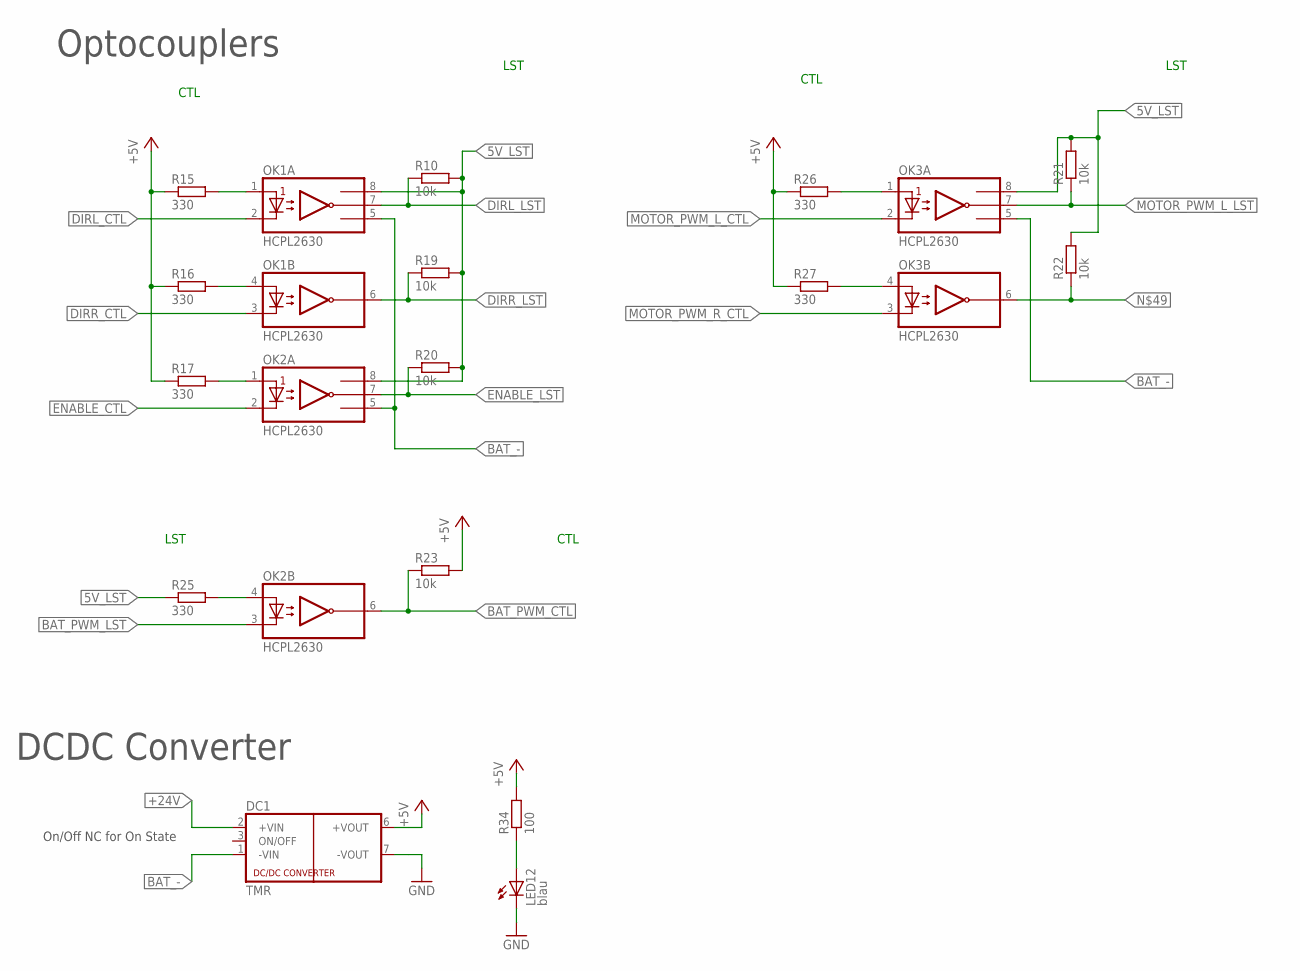
[picture p24: schematic regelschaltplan_e7.sch, sheet 5, galvanic decoupling]

Parts:
DC1: TMR; TRACO_SIP-8
LED12: blau; LED3MM
OK1, OK2, OK3: HCPL2630; DIL08
R10, R19, R20, R21, R22, R23: 10k; 0207/10
R15, R16, R17, R25, R26, R27: 330; 0207/10
R34: 100; 0207/10

Connections:
5V_LST: OK1.8 (VCC), OK2.8 (VCC), OK3.8 (VCC), R10.2, R19.2, R20.2, R21.2, R22.2, R25.1; also elsewhere on the board
+24V: DC1.2 (+VIN); also elsewhere on the board
BAT_-: DC1.1 (-VIN), OK1.5 (GND), OK2.5 (GND), OK3.5 (GND); also elsewhere on the board
BAT_PWM_CTL: OK2.6 (VO2), R23.1; also elsewhere on the board
BAT_PWM_LST: OK2.3 (C2); also elsewhere on the board
DIRL_CTL: OK1.2 (C1); also elsewhere on the board
DIRL_LST: OK1.7 (VO1), R10.1; also elsewhere on the board
DIRR_CTL: OK1.3 (C2); also elsewhere on the board
DIRR_LST: OK1.6 (VO2), R19.1; also elsewhere on the board
ENABLE_CTL: OK2.2 (C1); also elsewhere on the board
ENABLE_LST: OK2.7 (VO1), R20.1; also elsewhere on the board
GND: DC1.7 (-VOUT), LED12.K (C); also elsewhere on the board
MOTOR_PWM_L_CTL: OK3.2 (C1); also elsewhere on the board
MOTOR_PWM_L_LST: OK3.7 (VO1), R21.1; also elsewhere on the board
MOTOR_PWM_R_CTL: OK3.3 (C2); also elsewhere on the board
unnamed 58: DC1.6 (+VOUT), R15.1, R16.1, R17.1, R23.2, R26.1, R27.1, R34.2; also elsewhere on the board
unnamed: OK1.1 (A1), R15.2
unnamed: OK1.4 (A2), R16.2
unnamed: OK2.1 (A1), R17.2
unnamed: OK2.4 (A2), R25.2
unnamed: OK3.4 (A2), R27.2
unnamed: OK3.1 (A1), R26.2
unnamed: LED12.A, R34.1
unnamed 71: OK3.6 (VO2), R22.1; also elsewhere on the board

Notes on the sheet:
DCDC Converter
On/Off NC for On State
Optocouplers
LST
CTL

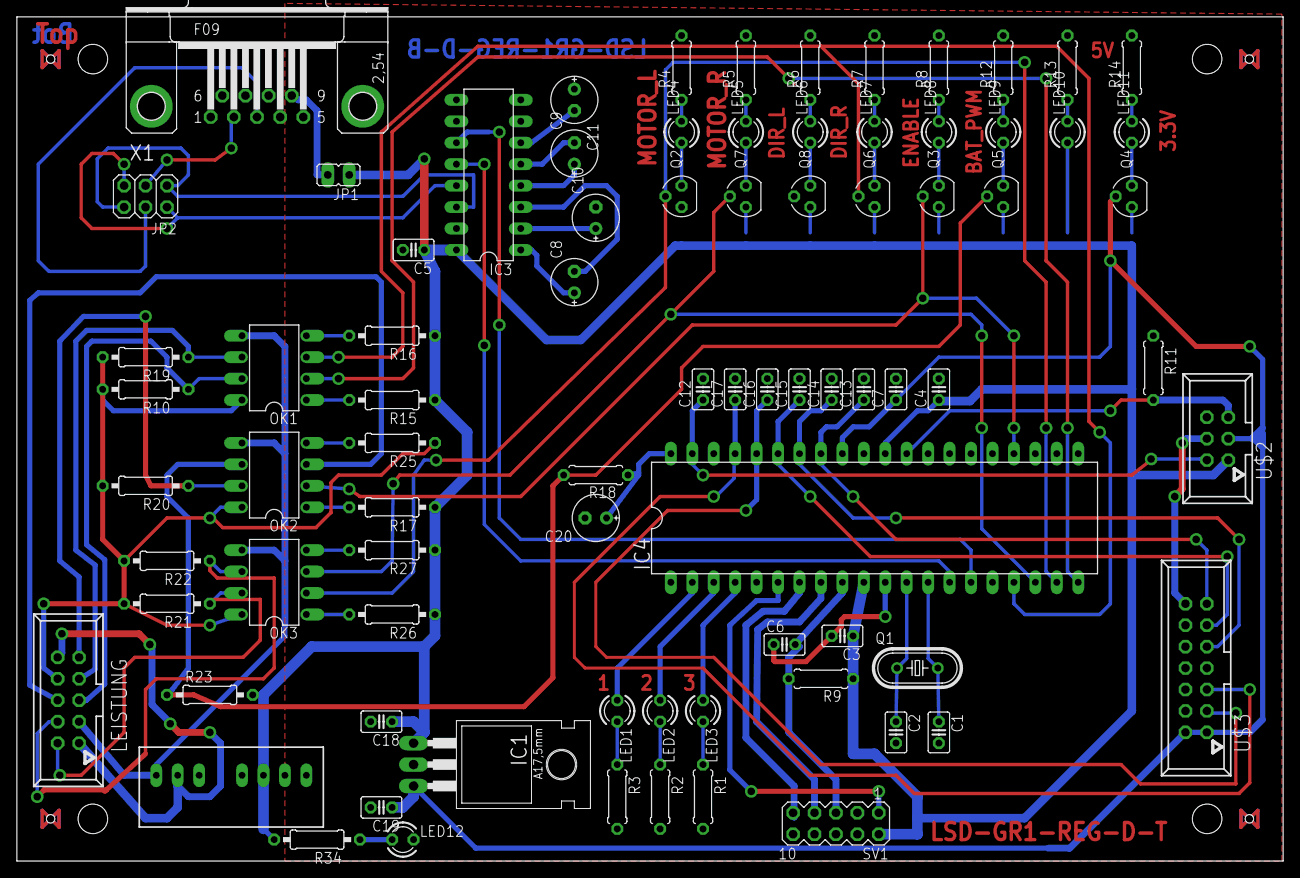
[picture p25: board regelschaltplan_e7.brd from above]

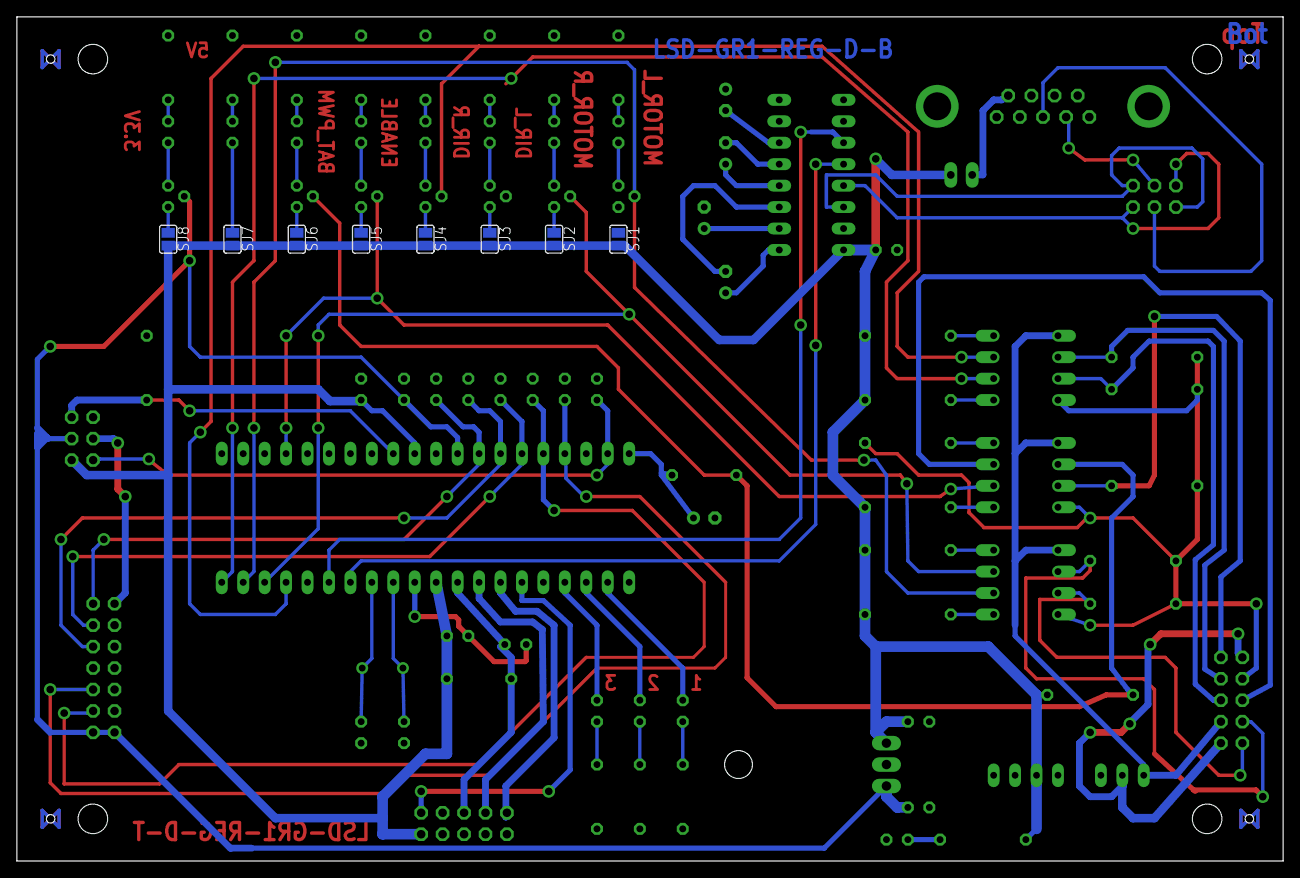
[picture p26: board regelschaltplan_e7.brd from below]

Board: 2 copper layers, 150.0 x 100.0 mm, 90 parts (8 on the bottom side), 81 nets.

Other parts of the board:
U$1: BOARD
