L31N/lsd/LSDTivSegG1/display.brd

## EAGLE design LSDTivSegG1/display.brd (2018-10-08)

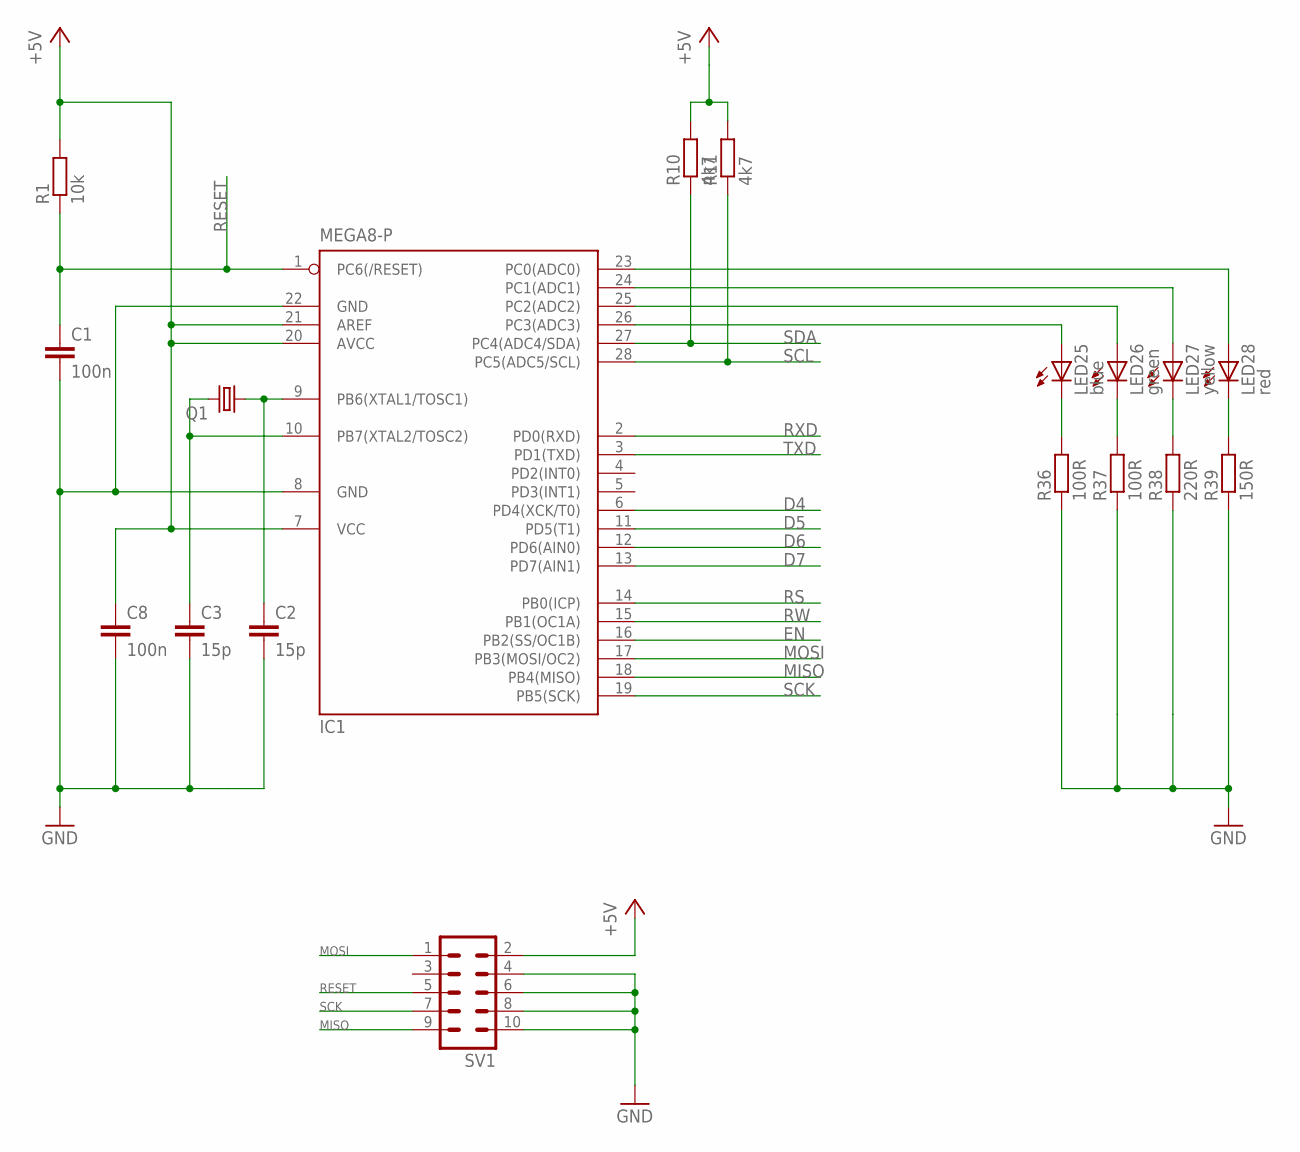
[picture p27: schematic display.sch, sheet 1, Atmega8]

Parts:
C1, C8: 100n; C025-025X050
C2, C3: 15p; C025-025X050
IC1: MEGA8-P; DIL28-3
LED25: blue; LED3MM
LED26: green; LED3MM
LED27: yellow; LED3MM
LED28: red; LED3MM
Q1: CRYSTALHC49U-V; HC49U-V
R1: 10k; 0207/10
R10, R11: 4k7; 0207/10
R36, R37: 100R; 0207/10
R38: 220R; 0207/10
R39: 150R; 0207/10
SV1: ML10

Connections:
+5V: C8.1, IC1.7 (VCC), IC1.20 (AVCC), IC1.21 (AREF), R1.2, R10.2, R11.2, SV1.2; also elsewhere on the board
D4: IC1.6 (PD4(XCK/T0)); also elsewhere on the board
D5: IC1.11 (PD5(T1)); also elsewhere on the board
D6: IC1.12 (PD6(AIN0)); also elsewhere on the board
D7: IC1.13 (PD7(AIN1)); also elsewhere on the board
EN: IC1.16 (PB2(SS/OC1B)); also elsewhere on the board
GND: C1.2, C2.2, C3.2, C8.2, IC1.8 (GND), IC1.22 (GND), R36.1, R37.1, R38.1, R39.1, SV1.4, SV1.6, SV1.8, SV1.10; also elsewhere on the board
MISO: IC1.18 (PB4(MISO)), SV1.9
MOSI: IC1.17 (PB3(MOSI/OC2)), SV1.1
unnamed: C2.1, IC1.9 (PB6(XTAL1/TOSC1)), Q1.1
unnamed: C3.1, IC1.10 (PB7(XTAL2/TOSC2)), Q1.2
unnamed: IC1.23 (PC0(ADC0)), LED28.A
unnamed: IC1.24 (PC1(ADC1)), LED27.A
unnamed: IC1.25 (PC2(ADC2)), LED26.A
unnamed: IC1.26 (PC3(ADC3)), LED25.A
unnamed: LED28.K (C), R39.2
unnamed: LED27.K (C), R38.2
unnamed: LED26.K (C), R37.2
unnamed: LED25.K (C), R36.2
RESET: C1.1, IC1.1 (PC6(/RESET)), R1.1, SV1.5
RS: IC1.14 (PB0(ICP)); also elsewhere on the board
RW: IC1.15 (PB1(OC1A)); also elsewhere on the board
RXD: IC1.2 (PD0(RXD)); also elsewhere on the board
SCK: IC1.19 (PB5(SCK)), SV1.7
SCL: IC1.28 (PC5(ADC5/SCL)), R11.1; also elsewhere on the board
SDA: IC1.27 (PC4(ADC4/SDA)), R10.1; also elsewhere on the board
TXD: IC1.3 (PD1(TXD)); also elsewhere on the board

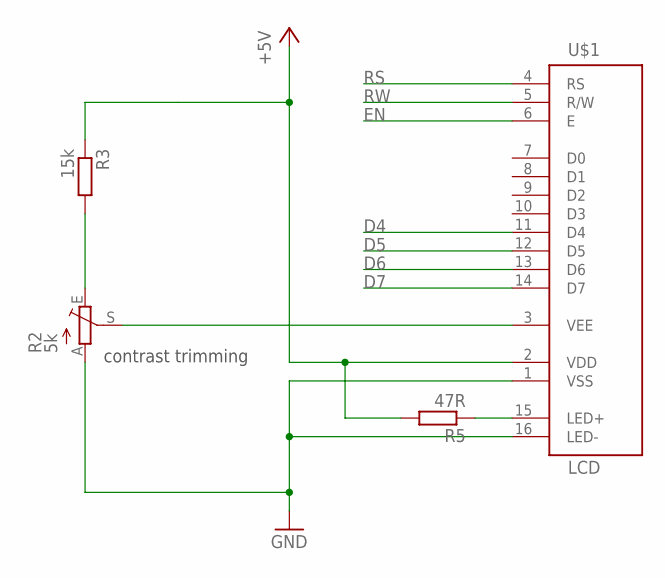
[picture p28: schematic display.sch, sheet 2]

Parts:
R2: 5k; PT-10
R3: 15k; 0207/10
R5: 47R; 0207/10
U$1: LCD

Connections:
+5V: R3.1, R5.2, U$1.2 (VDD); also elsewhere on the board
D4: U$1.11 (D4); also elsewhere on the board
D5: U$1.12 (D5); also elsewhere on the board
D6: U$1.13 (D6); also elsewhere on the board
D7: U$1.14 (D7); also elsewhere on the board
EN: U$1.6 (E); also elsewhere on the board
GND: R2.A, U$1.1 (VSS), U$1.16 (LED-); also elsewhere on the board
unnamed: R2.E, R3.2
unnamed: R2.S, U$1.3 (VEE)
unnamed: R5.1, U$1.15 (LED+)
RS: U$1.4 (RS); also elsewhere on the board
RW: U$1.5 (R/W); also elsewhere on the board

Notes on the sheet:
contrast trimming

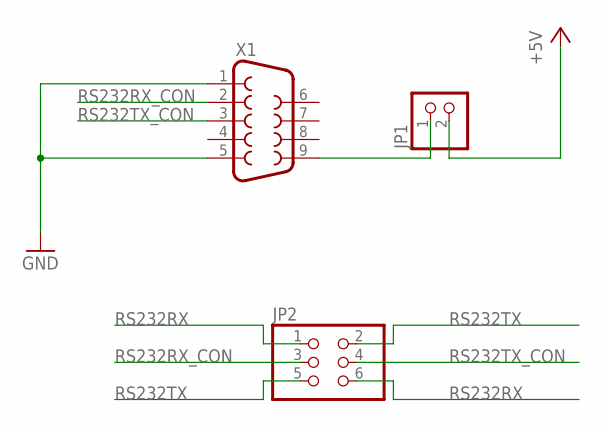
[picture p29: schematic display.sch, sheet 3, Connectors]

Parts:
JP1: PINHD-1X2; 1X02
JP2: PINHD-2X3; 2X03
X1: F09HP

Connections:
+5V: JP1.2; also elsewhere on the board
GND: X1.1, X1.5; also elsewhere on the board
unnamed: JP1.1, X1.9
RS232RX: JP2.1, JP2.6; also elsewhere on the board
RS232RX_CON: JP2.3, X1.2
RS232TX: JP2.2, JP2.5; also elsewhere on the board
RS232TX_CON: JP2.4, X1.3

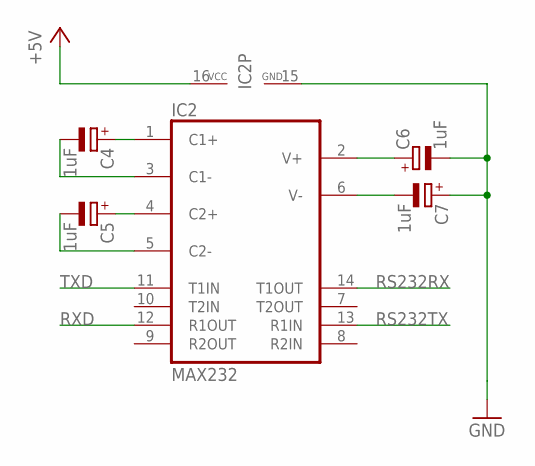
[picture p30: schematic display.sch, sheet 4, RS232]

Parts:
C4, C5, C6, C7: 1uF; E2,5-5
IC2: MAX232; DIL16

Connections:
+5V: IC2.16 (VCC); also elsewhere on the board
GND: C6.-, C7.+, IC2.15 (GND); also elsewhere on the board
unnamed: C4.+, IC2.1 (C1+)
unnamed: C5.+, IC2.4 (C2+)
unnamed: C5.-, IC2.5 (C2-)
unnamed: C4.-, IC2.3 (C1-)
unnamed: C6.+, IC2.2 (V+)
unnamed: C7.-, IC2.6 (V-)
RS232RX: IC2.14 (T1OUT); also elsewhere on the board
RS232TX: IC2.13 (R1IN); also elsewhere on the board
RXD: IC2.12 (R1OUT); also elsewhere on the board
TXD: IC2.11 (T1IN); also elsewhere on the board

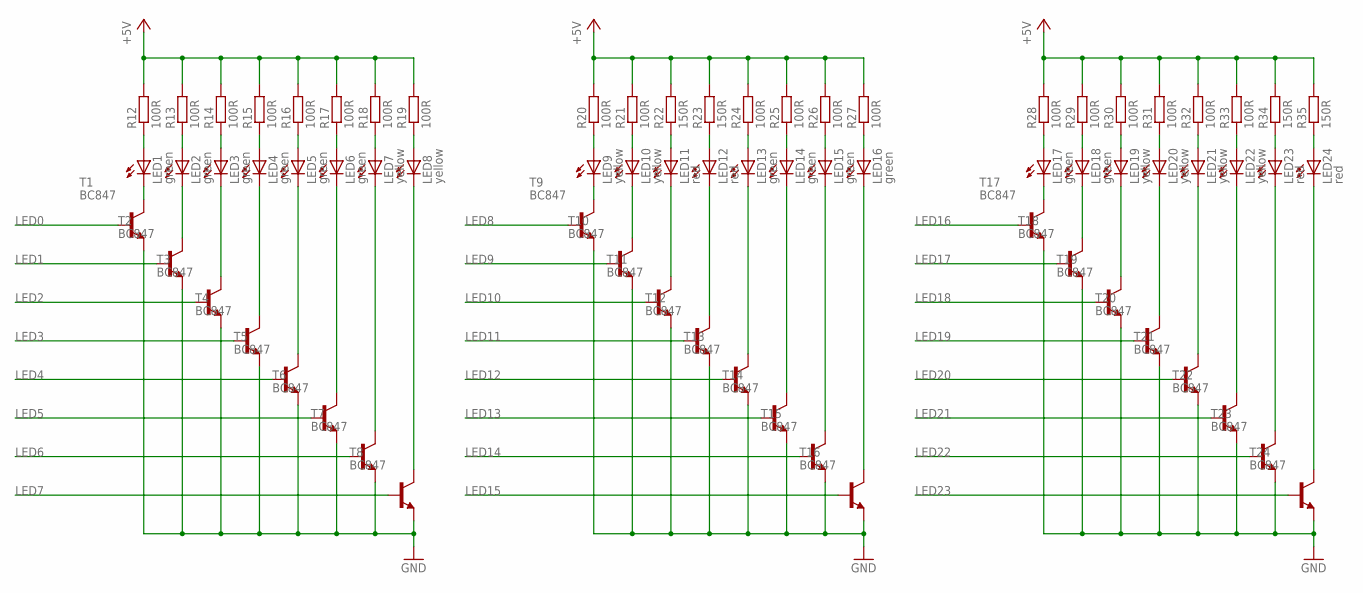
[picture p31: schematic display.sch, sheet 5, LED Bar]

Parts:
LED1, LED2, LED3, LED4, LED5, LED6, LED13, LED14, LED15, LED16, LED17, LED18: green; LED5MM
LED7, LED8, LED9, LED10, LED19, LED20, LED21, LED22: yellow; LED5MM
LED11, LED12, LED23, LED24: red; LED5MM
R12, R13, R14, R15, R16, R17, R18, R19, R20, R21, R24, R25, R26, R27, R28, R29, R30, R31, R32, R33: 100R; 0207/10
R22, R23, R34, R35: 150R; 0207/10
T1, T2, T3, T4, T5, T6, T7, T8, T9, T10, T11, T12, T13, T14, T15, T16, T17, T18, T19, T20, T21, T22, T23, T24: BC847; SOT23

Connections:
+5V: R12.2, R13.2, R14.2, R15.2, R16.2, R17.2, R18.2, R19.2, R20.2, R21.2, R22.2, R23.2, R24.2, R25.2, R26.2, R27.2, R28.2, R29.2, R30.2, R31.2, R32.2, R33.2, R34.2, R35.2; also elsewhere on the board
GND: T1.2 (E), T2.2 (E), T3.2 (E), T4.2 (E), T5.2 (E), T6.2 (E), T7.2 (E), T8.2 (E), T9.2 (E), T10.2 (E), T11.2 (E), T12.2 (E), T13.2 (E), T14.2 (E), T15.2 (E), T16.2 (E), T17.2 (E), T18.2 (E), T19.2 (E), T20.2 (E), T21.2 (E), T22.2 (E), T23.2 (E), T24.2 (E); also elsewhere on the board
LED0: T1.1 (B); also elsewhere on the board
LED1: T2.1 (B); also elsewhere on the board
LED2: T3.1 (B); also elsewhere on the board
LED3: T4.1 (B); also elsewhere on the board
LED4: T5.1 (B); also elsewhere on the board
LED5: T6.1 (B); also elsewhere on the board
LED6: T7.1 (B); also elsewhere on the board
LED7: T8.1 (B); also elsewhere on the board
LED8: T9.1 (B); also elsewhere on the board
LED9: T10.1 (B); also elsewhere on the board
LED10: T11.1 (B); also elsewhere on the board
LED11: T12.1 (B); also elsewhere on the board
LED12: T13.1 (B); also elsewhere on the board
LED13: T14.1 (B); also elsewhere on the board
LED14: T15.1 (B); also elsewhere on the board
LED15: T16.1 (B); also elsewhere on the board
LED16: T17.1 (B); also elsewhere on the board
LED17: T18.1 (B); also elsewhere on the board
LED18: T19.1 (B); also elsewhere on the board
LED19: T20.1 (B); also elsewhere on the board
LED20: T21.1 (B); also elsewhere on the board
LED21: T22.1 (B); also elsewhere on the board
LED22: T23.1 (B); also elsewhere on the board
LED23: T24.1 (B); also elsewhere on the board
unnamed: LED1.A, R12.1
unnamed: LED2.A, R13.1
unnamed: LED3.A, R14.1
unnamed: LED4.A, R15.1
unnamed: LED5.A, R16.1
unnamed: LED6.A, R17.1
unnamed: LED7.A, R18.1
unnamed: LED8.A, R19.1
unnamed: LED9.A, R20.1
unnamed: LED10.A, R21.1
unnamed: LED11.A, R22.1
unnamed: LED12.A, R23.1
unnamed: LED13.A, R24.1
unnamed: LED14.A, R25.1
unnamed: LED15.A, R26.1
unnamed: LED16.A, R27.1
unnamed: LED17.A, R28.1
unnamed: LED18.A, R29.1
unnamed: LED19.A, R30.1
unnamed: LED20.A, R31.1
unnamed: LED21.A, R32.1
unnamed: LED22.A, R33.1
unnamed: LED23.A, R34.1
unnamed: LED24.A, R35.1
unnamed: LED9.K (C), T9.3 (C)
unnamed: LED1.K (C), T1.3 (C)
unnamed: LED2.K (C), T2.3 (C)
unnamed: LED3.K (C), T3.3 (C)
unnamed: LED4.K (C), T4.3 (C)
unnamed: LED5.K (C), T5.3 (C)
unnamed: LED6.K (C), T6.3 (C)
unnamed: LED17.K (C), T17.3 (C)
unnamed: LED10.K (C), T10.3 (C)
unnamed: LED11.K (C), T11.3 (C)
unnamed: LED12.K (C), T12.3 (C)
unnamed: LED13.K (C), T13.3 (C)
unnamed: LED14.K (C), T14.3 (C)
unnamed: LED7.K (C), T7.3 (C)
unnamed: LED8.K (C), T8.3 (C)
unnamed: LED15.K (C), T15.3 (C)
unnamed: LED16.K (C), T16.3 (C)
unnamed: LED18.K (C), T18.3 (C)
unnamed: LED19.K (C), T19.3 (C)
unnamed: LED20.K (C), T20.3 (C)
unnamed: LED21.K (C), T21.3 (C)
unnamed: LED22.K (C), T22.3 (C)
unnamed: LED23.K (C), T23.3 (C)
unnamed: LED24.K (C), T24.3 (C)

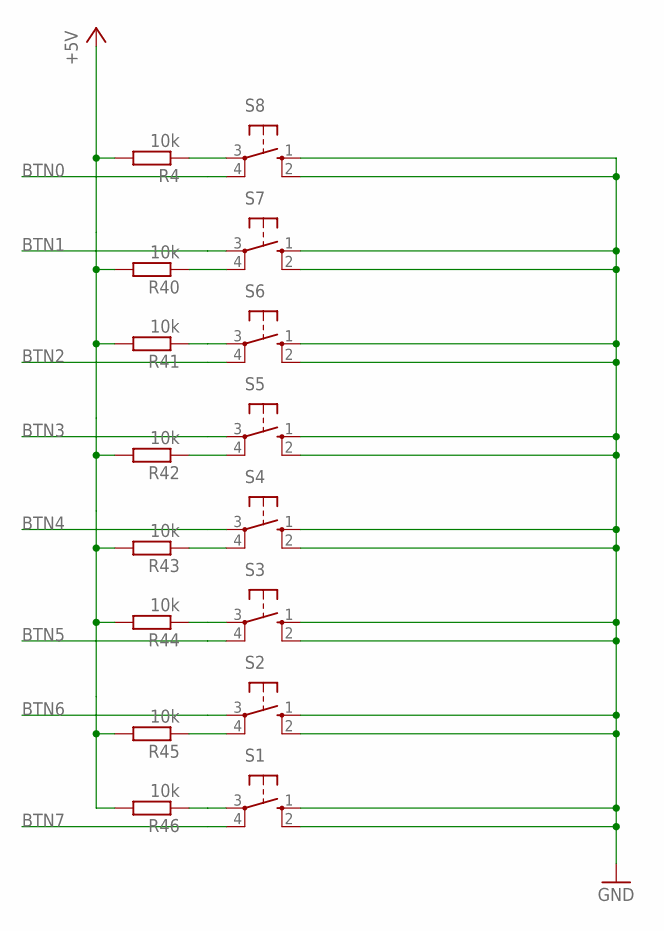
[picture p32: schematic display.sch, sheet 6, Buttons]

Parts:
R4, R40, R41, R42, R43, R44, R45, R46: 10k; R0805
S1, S2, S3, S4, S5, S6, S7, S8: 10-XX; B3F-10XX

Connections:
+5V: R4.2, R40.2, R41.2, R42.2, R43.2, R44.2, R45.2, R46.2; also elsewhere on the board
BTN0: S8.4 (P1); also elsewhere on the board
BTN1: S7.3; also elsewhere on the board
BTN2: S6.4 (P1); also elsewhere on the board
BTN3: S5.3; also elsewhere on the board
BTN4: S4.3; also elsewhere on the board
BTN5: S3.4 (P1); also elsewhere on the board
BTN6: S2.3; also elsewhere on the board
BTN7: S1.4 (P1); also elsewhere on the board
GND: S1.1 (S), S1.2 (S1), S2.1 (S), S2.2 (S1), S3.1 (S), S3.2 (S1), S4.1 (S), S4.2 (S1), S5.1 (S), S5.2 (S1), S6.1 (S), S6.2 (S1), S7.1 (S), S7.2 (S1), S8.1 (S), S8.2 (S1); also elsewhere on the board
unnamed: R4.1, S8.3
unnamed: R41.1, S6.3
unnamed: R45.1, S2.4 (P1)
unnamed: R43.1, S4.4 (P1)
unnamed: R44.1, S3.3
unnamed: R42.1, S5.4 (P1)
unnamed: R46.1, S1.3
unnamed: R40.1, S7.4 (P1)
