L31N/lsd/LSDTivSegG1/display.brd

## EAGLE design LSDTivSegG1/display.brd (continued)

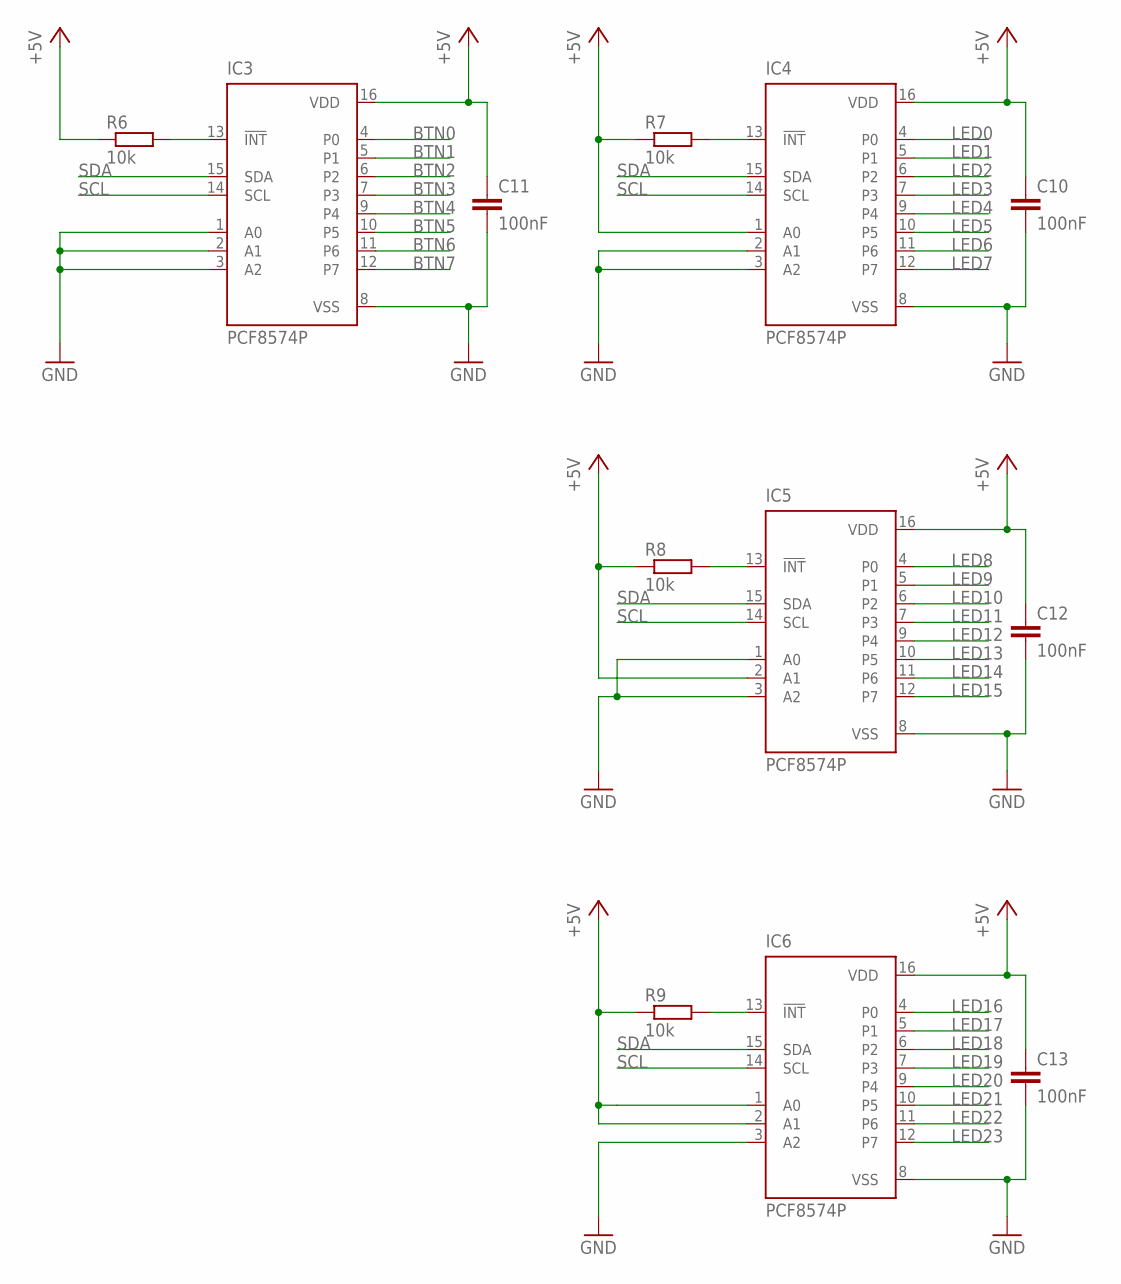
[picture p33: schematic display.sch, sheet 7, IO Expander]

Parts:
C10, C11, C12, C13: 100nF; C025-025X050
IC3, IC4, IC5, IC6: PCF8574P; DIL16
R6, R7, R8, R9: 10k; 0207/10

Connections:
+5V: C10.1, C11.1, C12.1, C13.1, IC3.16 (VDD), IC4.1 (A0), IC4.16 (VDD), IC5.2 (A1), IC5.16 (VDD), IC6.1 (A0), IC6.2 (A1), IC6.16 (VDD), R6.1, R7.1, R8.1, R9.1; also elsewhere on the board
BTN0: IC3.4 (P0); also elsewhere on the board
BTN1: IC3.5 (P1); also elsewhere on the board
BTN2: IC3.6 (P2); also elsewhere on the board
BTN3: IC3.7 (P3); also elsewhere on the board
BTN4: IC3.9 (P4); also elsewhere on the board
BTN5: IC3.10 (P5); also elsewhere on the board
BTN6: IC3.11 (P6); also elsewhere on the board
BTN7: IC3.12 (P7); also elsewhere on the board
GND: C10.2, C11.2, C12.2, C13.2, IC3.1 (A0), IC3.2 (A1), IC3.3 (A2), IC3.8 (VSS), IC4.2 (A1), IC4.3 (A2), IC4.8 (VSS), IC5.1 (A0), IC5.3 (A2), IC5.8 (VSS), IC6.3 (A2), IC6.8 (VSS); also elsewhere on the board
LED0: IC4.4 (P0); also elsewhere on the board
LED1: IC4.5 (P1); also elsewhere on the board
LED2: IC4.6 (P2); also elsewhere on the board
LED3: IC4.7 (P3); also elsewhere on the board
LED4: IC4.9 (P4); also elsewhere on the board
LED5: IC4.10 (P5); also elsewhere on the board
LED6: IC4.11 (P6); also elsewhere on the board
LED7: IC4.12 (P7); also elsewhere on the board
LED8: IC5.4 (P0); also elsewhere on the board
LED9: IC5.5 (P1); also elsewhere on the board
LED10: IC5.6 (P2); also elsewhere on the board
LED11: IC5.7 (P3); also elsewhere on the board
LED12: IC5.9 (P4); also elsewhere on the board
LED13: IC5.10 (P5); also elsewhere on the board
LED14: IC5.11 (P6); also elsewhere on the board
LED15: IC5.12 (P7); also elsewhere on the board
LED16: IC6.4 (P0); also elsewhere on the board
LED17: IC6.5 (P1); also elsewhere on the board
LED18: IC6.6 (P2); also elsewhere on the board
LED19: IC6.7 (P3); also elsewhere on the board
LED20: IC6.9 (P4); also elsewhere on the board
LED21: IC6.10 (P5); also elsewhere on the board
LED22: IC6.11 (P6); also elsewhere on the board
LED23: IC6.12 (P7); also elsewhere on the board
unnamed: IC3.13 (!INT), R6.2
unnamed: IC4.13 (!INT), R7.2
unnamed: IC5.13 (!INT), R8.2
unnamed: IC6.13 (!INT), R9.2
SCL: IC3.14 (SCL), IC4.14 (SCL), IC5.14 (SCL), IC6.14 (SCL); also elsewhere on the board
SDA: IC3.15 (SDA), IC4.15 (SDA), IC5.15 (SDA), IC6.15 (SDA); also elsewhere on the board

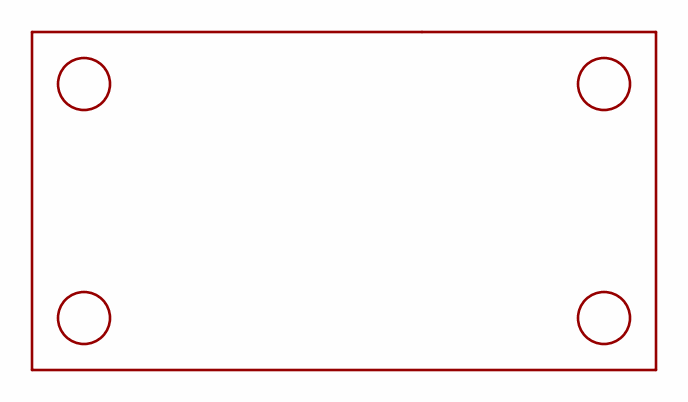
[picture p34: schematic display.sch, sheet 8, PCB Dimensions]

Parts:
U$2: DISPLAY_FRAME

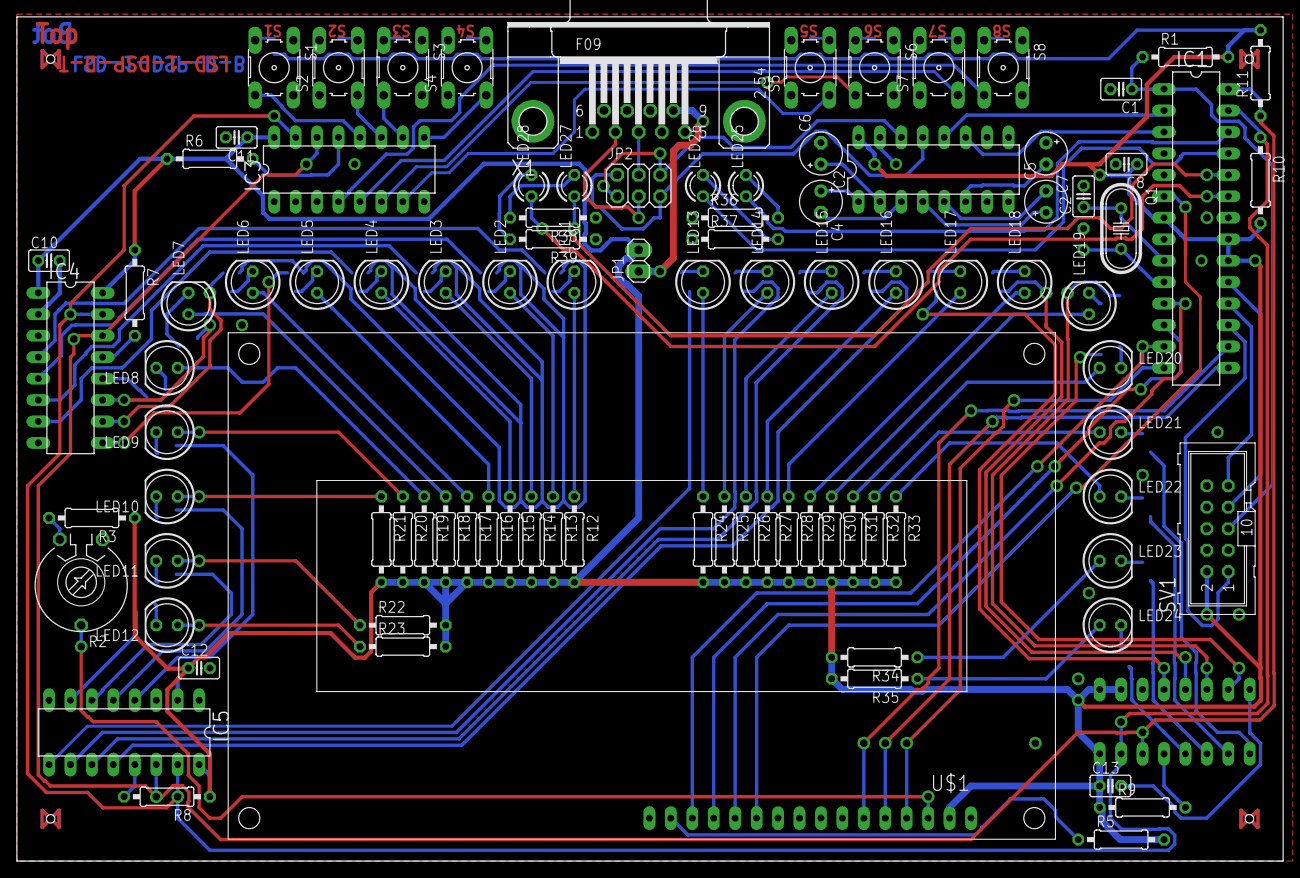
[picture p35: board display.brd from above]

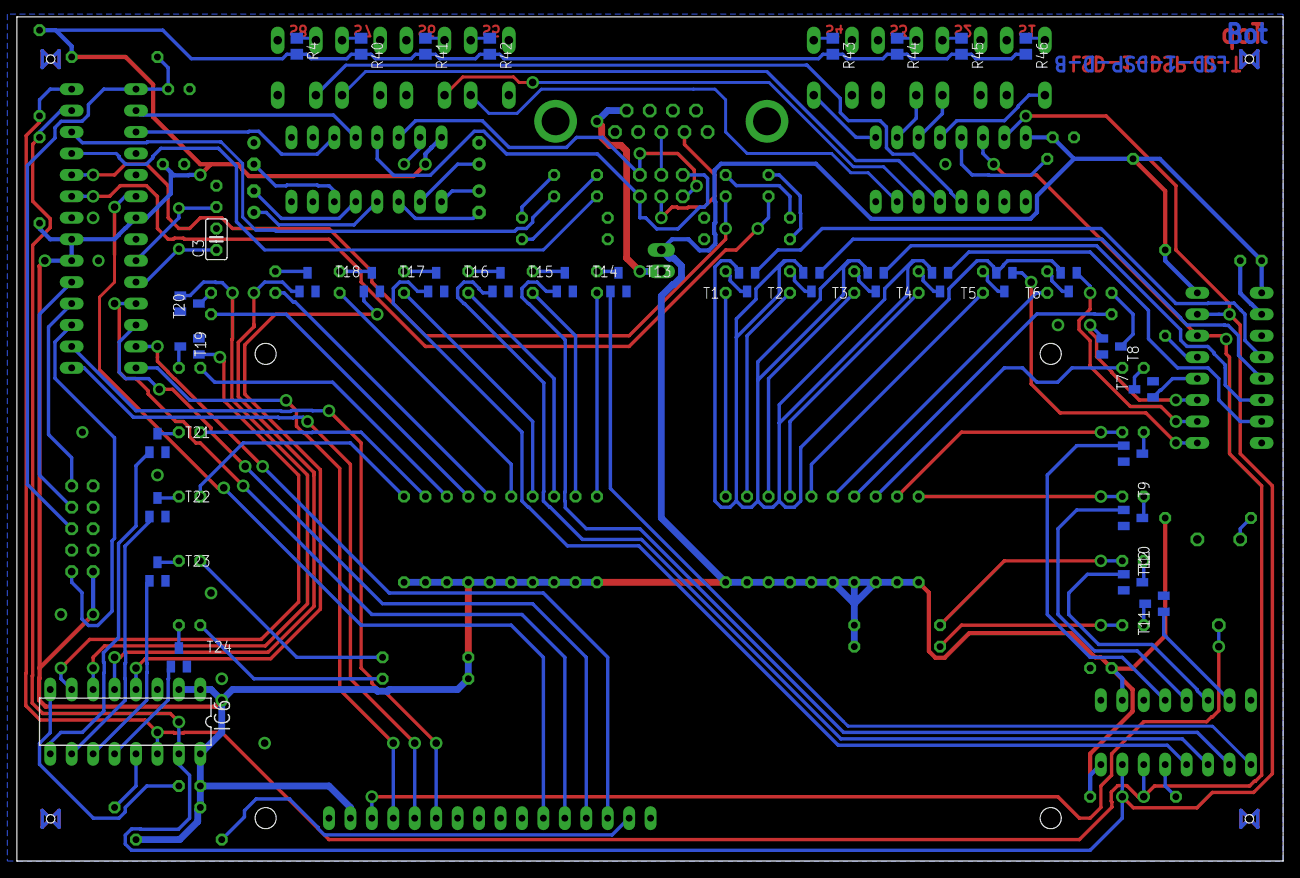
[picture p36: board display.brd from below]

Board: 2 copper layers, 150.0 x 100.0 mm, 131 parts (34 on the bottom side), 133 nets.
