L31N/lsd/LSDTivSegG1/leistung_e7.brd

## EAGLE design LSDTivSegG1/leistung_e7.brd (2018-10-05)

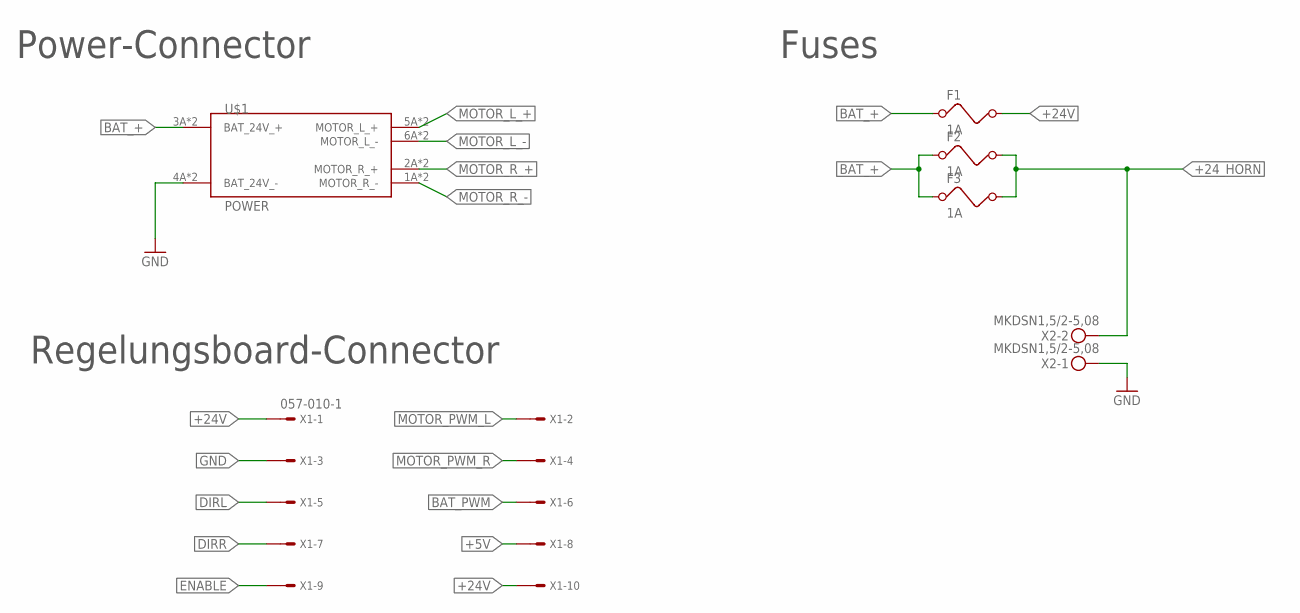
[picture p37: schematic leistung_e7.sch, sheet 1, connectors]

Parts:
F1, F2, F3: 1A; FUSE
U$1: POWER; CON_POWER
X1: 057-010-1
X2: MKDSN1,5/2-5,08

Connections:
+5V: X1.8; also elsewhere on the board
+24V: F1.2, X1.1, X1.10; also elsewhere on the board
+24_HORN: F2.2, F3.2, X2.2
BAT_+: F1.1, F2.1, F3.1, U$1.3A (BAT_24V_+), U$1.3B (BAT_24V_+); also elsewhere on the board
BAT_PWM: X1.6; also elsewhere on the board
DIRL: X1.5; also elsewhere on the board
DIRR: X1.7; also elsewhere on the board
ENABLE: X1.9; also elsewhere on the board
GND: U$1.4A (BAT_24V_-), U$1.4B (BAT_24V_-), X1.3, X2.1; also elsewhere on the board
MOTOR_L_+: U$1.5A (MOTOR_L_+), U$1.5B (MOTOR_L_+); also elsewhere on the board
MOTOR_L_-: U$1.6A (MOTOR_L_-), U$1.6B (MOTOR_L_-); also elsewhere on the board
MOTOR_PWM_L: X1.2; also elsewhere on the board
MOTOR_PWM_R: X1.4; also elsewhere on the board
MOTOR_R_+: U$1.2A (MOTOR_R_+), U$1.2B (MOTOR_R_+); also elsewhere on the board
MOTOR_R_-: U$1.1A (MOTOR_R_-), U$1.1B (MOTOR_R_-); also elsewhere on the board

Notes on the sheet:
Power-Connector
Regelungsboard-Connector
Fuses

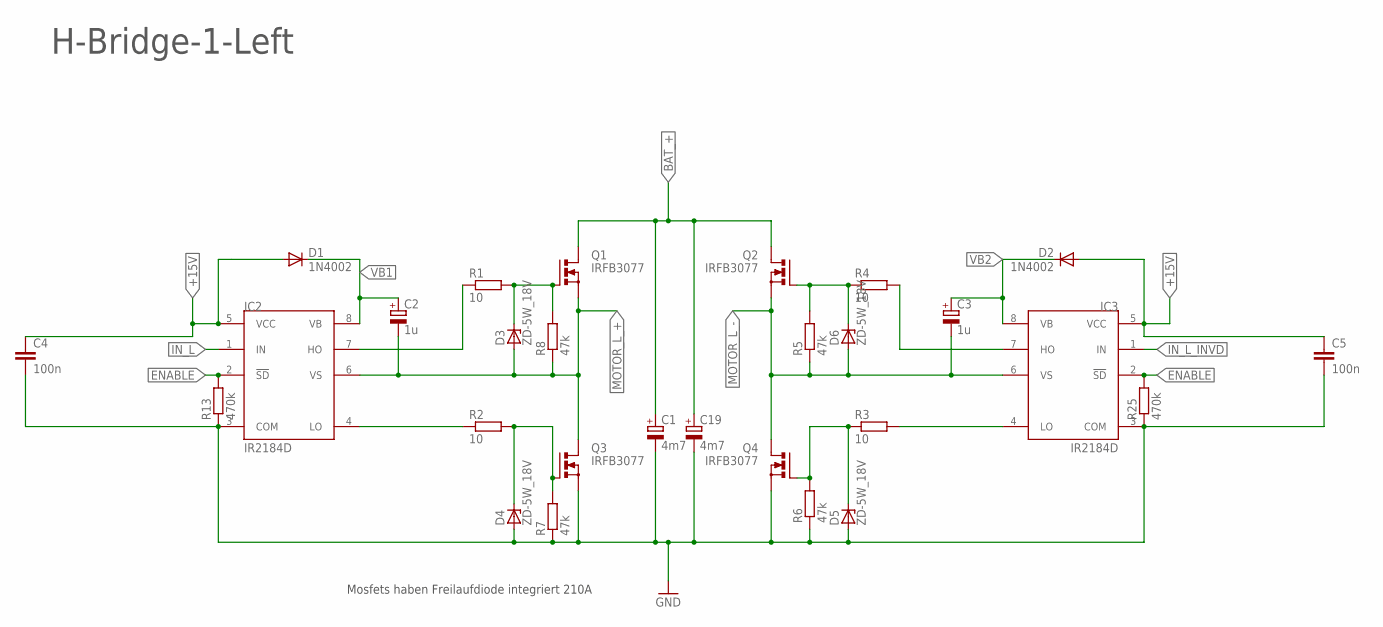
[picture p38: schematic leistung_e7.sch, sheet 2, h-bridge-left]

Parts:
C1, C19: 4m7; E7,5-18
C2, C3: 1u; E2,5-5
C4, C5: 100n; C025-025X050
D1, D2: 1N4002; DO41-10
D3, D4, D5, D6: ZD-5W_18V; ZDIO-10
IC2, IC3: IR2184D; DIL08
Q1, Q2, Q3, Q4: IRFB3077; TO220BV
R1, R2, R3, R4: 10; 0207/7
R5, R6, R7, R8: 47k; 0207/7
R13, R25: 470k; 0207/7

Connections:
+15V: C4.1, C5.1, D1.A, D2.A, IC2.5 (VCC), IC3.5 (VCC); also elsewhere on the board
BAT_+: C1.+, C19.+, Q1.D, Q2.D; also elsewhere on the board
ENABLE: IC2.2 (!SD), IC3.2 (!SD), R13.2, R25.2; also elsewhere on the board
GND: C1.-, C4.2, C5.2, C19.-, D4.A, D5.A, IC2.3 (COM), IC3.3 (COM), Q3.S, Q4.S, R6.1, R7.1, R13.1, R25.1; also elsewhere on the board
IN_L: IC2.1 (IN); also elsewhere on the board
IN_L_INVD: IC3.1 (IN); also elsewhere on the board
MOTOR_L_+: C2.-, D3.A, IC2.6 (VS), Q1.S, Q3.D, R8.1; also elsewhere on the board
MOTOR_L_-: C3.-, D6.A, IC3.6 (VS), Q2.S, Q4.D, R5.1; also elsewhere on the board
unnamed: D4.C, Q3.G, R2.2, R7.2
unnamed: D3.C, Q1.G, R1.2, R8.2
unnamed: D6.C, Q2.G, R4.1, R5.2
unnamed: D5.C, Q4.G, R3.1, R6.2
unnamed: IC2.4 (LO), R2.1
unnamed: IC2.7 (HO), R1.1
unnamed: IC3.7 (HO), R4.2
unnamed: IC3.4 (LO), R3.2
VB1: C2.+, D1.C, IC2.8 (VB)
VB2: C3.+, D2.C, IC3.8 (VB)

Notes on the sheet:
H-Bridge-1-Left
Mosfets haben Freilaufdiode integriert 210A

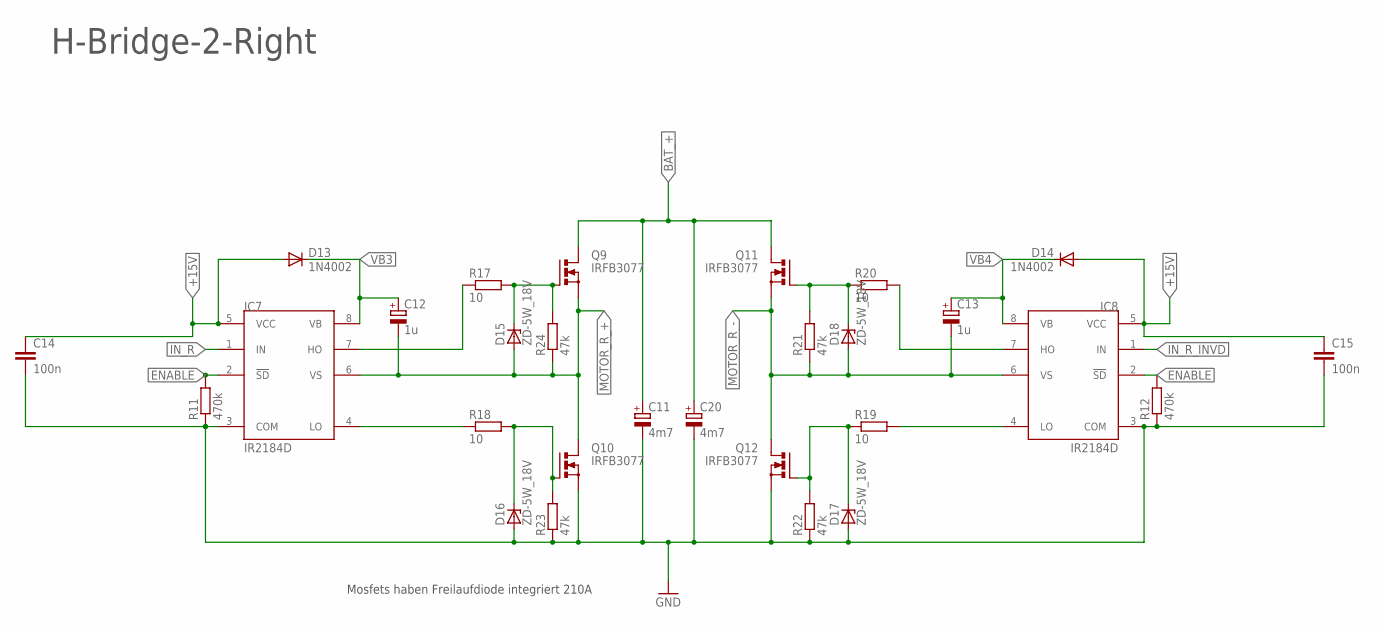
[picture p39: schematic leistung_e7.sch, sheet 3, h-bridge-right]

Parts:
C11, C20: 4m7; E7,5-18
C12, C13: 1u; E2,5-5
C14, C15: 100n; C025-025X050
D13, D14: 1N4002; DO41-10
D15, D16, D17, D18: ZD-5W_18V; ZDIO-10
IC7, IC8: IR2184D; DIL08
Q9, Q10, Q11, Q12: IRFB3077; TO220BV
R11, R12: 470k; 0207/7
R17, R18, R19, R20: 10; 0207/7
R21, R22, R23, R24: 47k; 0207/7

Connections:
+15V: C14.1, C15.1, D13.A, D14.A, IC7.5 (VCC), IC8.5 (VCC); also elsewhere on the board
BAT_+: C11.+, C20.+, Q9.D, Q11.D; also elsewhere on the board
ENABLE: IC7.2 (!SD), IC8.2 (!SD), R11.2, R12.2; also elsewhere on the board
GND: C11.-, C14.2, C15.2, C20.-, D16.A, D17.A, IC7.3 (COM), IC8.3 (COM), Q10.S, Q12.S, R11.1, R12.1, R22.1, R23.1; also elsewhere on the board
IN_R: IC7.1 (IN); also elsewhere on the board
IN_R_INVD: IC8.1 (IN); also elsewhere on the board
MOTOR_R_+: C12.-, D15.A, IC7.6 (VS), Q9.S, Q10.D, R24.1; also elsewhere on the board
MOTOR_R_-: C13.-, D18.A, IC8.6 (VS), Q11.S, Q12.D, R21.1; also elsewhere on the board
unnamed: D16.C, Q10.G, R18.2, R23.2
unnamed: D15.C, Q9.G, R17.2, R24.2
unnamed: D18.C, Q11.G, R20.1, R21.2
unnamed: D17.C, Q12.G, R19.1, R22.2
unnamed: IC7.4 (LO), R18.1
unnamed: IC7.7 (HO), R17.1
unnamed: IC8.7 (HO), R20.2
unnamed: IC8.4 (LO), R19.2
VB3: C12.+, D13.C, IC7.8 (VB)
VB4: C13.+, D14.C, IC8.8 (VB)

Notes on the sheet:
H-Bridge-2-Right
Mosfets haben Freilaufdiode integriert 210A

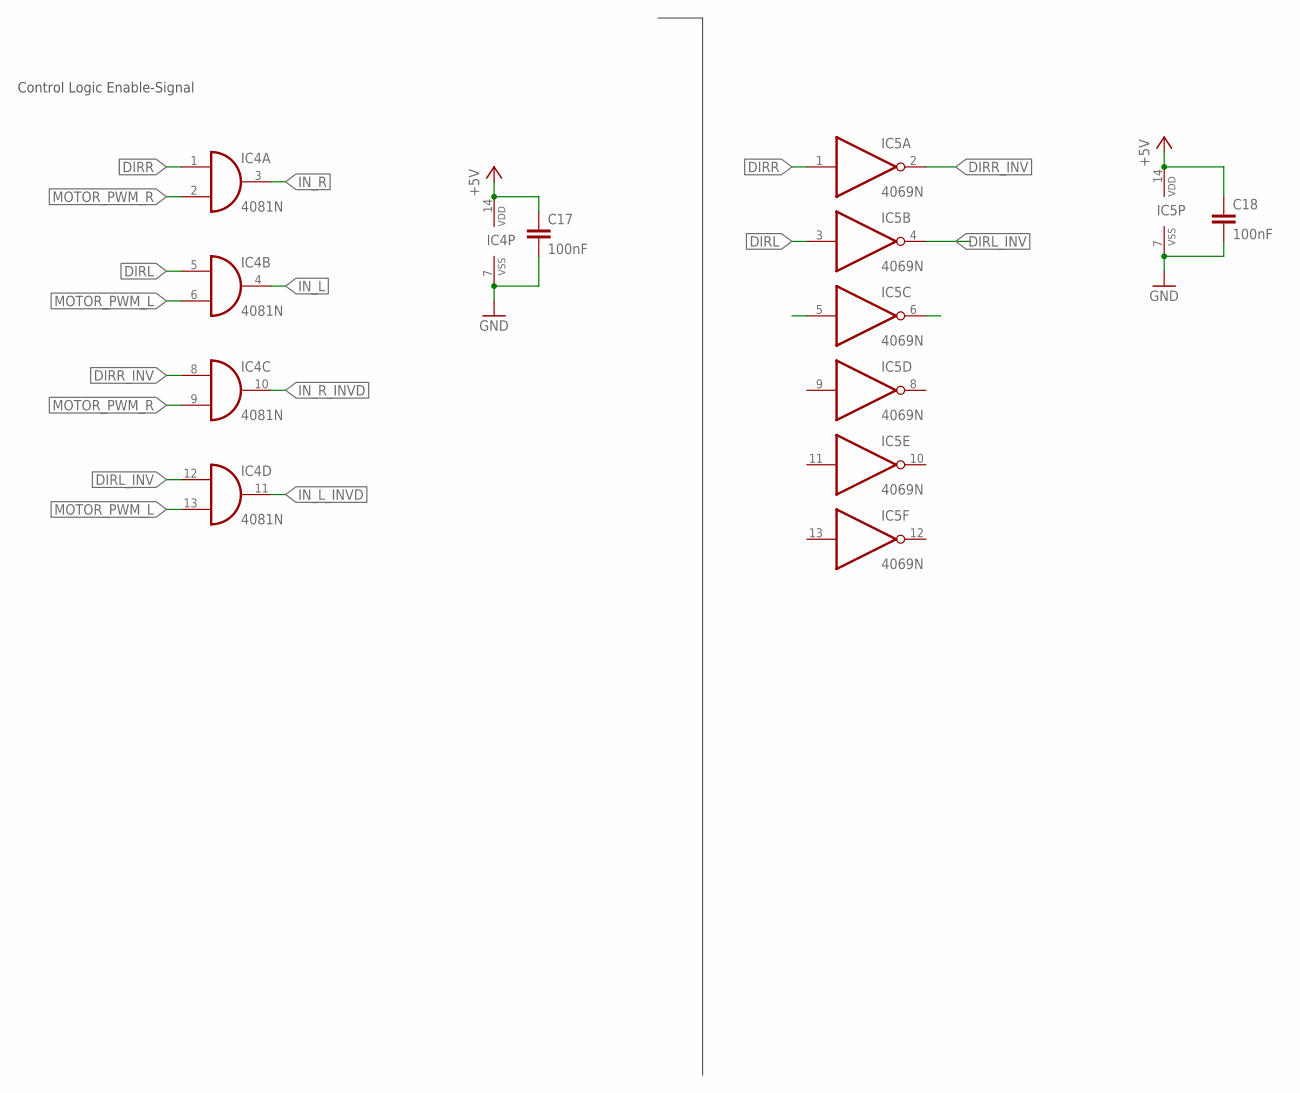
[picture p40: schematic leistung_e7.sch, sheet 4, driver-logic-gates]

Parts:
C17, C18: 100nF; C025-025X050
IC4: 4081N; DIL14
IC5: 4069N; DIL14

Connections:
+5V: C17.1, C18.1, IC4.14 (VDD), IC5.14 (VDD); also elsewhere on the board
DIRL: IC4.5 (I0), IC5.3 (I); also elsewhere on the board
DIRL_INV: IC4.12 (I0), IC5.4 (O)
DIRR: IC4.1 (I0), IC5.1 (I); also elsewhere on the board
DIRR_INV: IC4.8 (I0), IC5.2 (O)
GND: C17.2, C18.2, IC4.7 (VSS), IC5.7 (VSS); also elsewhere on the board
IN_L: IC4.4 (O); also elsewhere on the board
IN_L_INVD: IC4.11 (O); also elsewhere on the board
IN_R: IC4.3 (O); also elsewhere on the board
IN_R_INVD: IC4.10 (O); also elsewhere on the board
MOTOR_PWM_L: IC4.6 (I1), IC4.13 (I1); also elsewhere on the board
MOTOR_PWM_R: IC4.2 (I1), IC4.9 (I1); also elsewhere on the board

Notes on the sheet:
Control Logic Enable-Signal

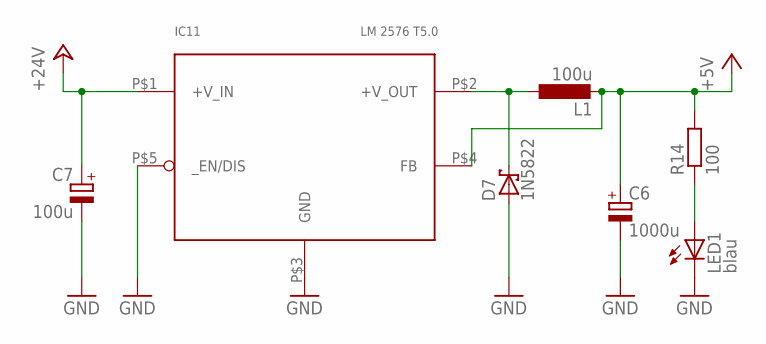
[picture p41: schematic leistung_e7.sch, sheet 5, stepdown-5V]

Parts:
C6: 1000u; E5-13
C7: 100u; E2,5-4R
D7: 1N5822; CB417-15
IC11: LM 2576 T5.0; TO220-5_STAGGERED
L1: 100u; 0207/10
LED1: blau; LED3MM
R14: 100; 0207/10

Connections:
+5V: C6.+, IC11.P$4 (FB), L1.2, R14.2; also elsewhere on the board
+24V: C7.+, IC11.P$1 (+V_IN); also elsewhere on the board
GND: C6.-, C7.-, D7.A, IC11.P$3 (GND), IC11.P$5 (_EN/DIS), LED1.K (C); also elsewhere on the board
unnamed: D7.C, IC11.P$2 (+V_OUT), L1.1
unnamed: LED1.A, R14.1

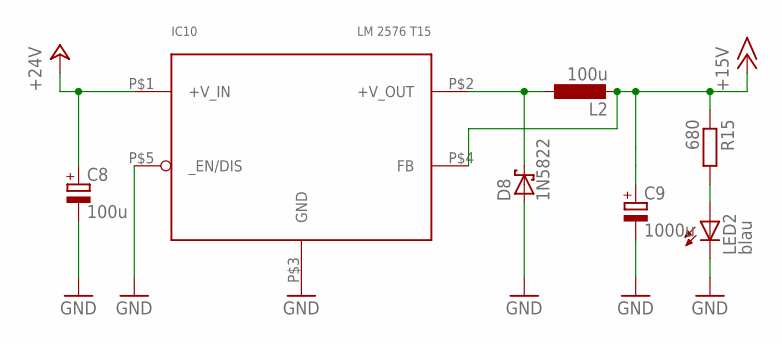
[picture p42: schematic leistung_e7.sch, sheet 6, stepdown-15V]

Parts:
C8: 100u; E2,5-7
C9: 1000u; E5-13
D8: 1N5822; CB429-15
IC10: LM 2576 T15; TO220-5_STAGGERED
L2: 100u; 0207/10
LED2: blau; LED3MM
R15: 680; 0207/10

Connections:
+15V: C9.+, IC10.P$4 (FB), L2.2, R15.1; also elsewhere on the board
+24V: C8.+, IC10.P$1 (+V_IN); also elsewhere on the board
GND: C8.-, C9.-, D8.A, IC10.P$3 (GND), IC10.P$5 (_EN/DIS), LED2.K (C); also elsewhere on the board
unnamed: LED2.A, R15.2
unnamed: D8.C, IC10.P$2 (+V_OUT), L2.1

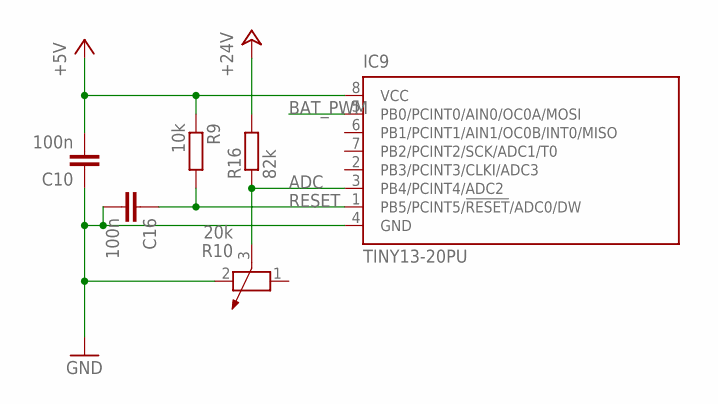
[picture p43: schematic leistung_e7.sch, sheet 7, ATTiny13-PWM]

Parts:
C10, C16: 100n; C025-025X050
IC9: TINY13-20PU; DIL08
R9: 10k; 0207/10
R10: 20k; PT-10
R16: 82k; 0207/10

Connections:
+5V: C10.2, IC9.8 (VCC), R9.1; also elsewhere on the board
+24V: R16.2; also elsewhere on the board
ADC: IC9.3 (PB4/PCINT4/ADC2), R10.3, R16.1
BAT_PWM: IC9.5 (PB0/PCINT0/AIN0/OC0A/MOSI); also elsewhere on the board
GND: C10.1, C16.2, IC9.4 (GND), R10.2; also elsewhere on the board
RESET: C16.1, IC9.1 (PB5/PCINT5/!RESET!/ADC0/DW), R9.2

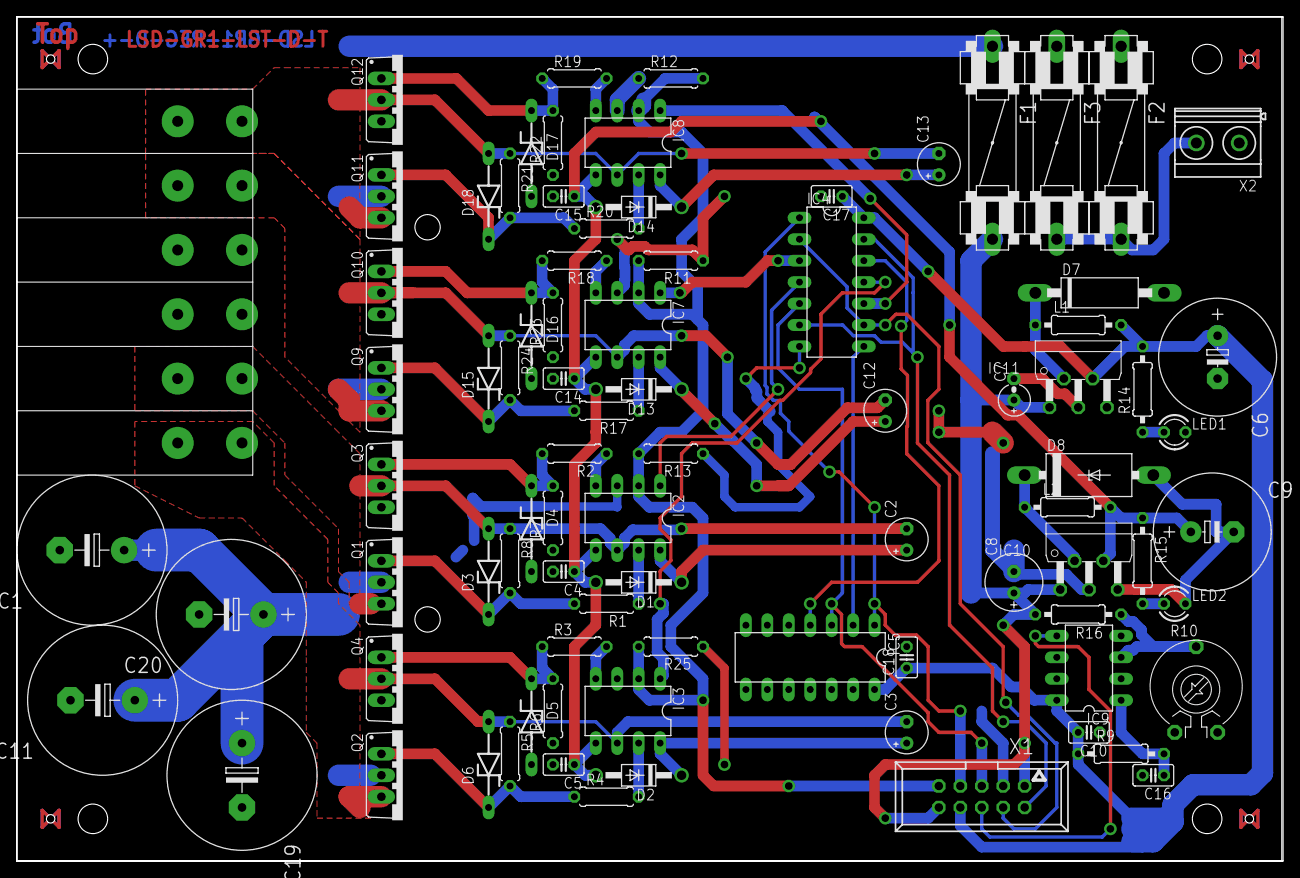
[picture p44: board leistung_e7.brd from above]

Board: 2 copper layers, 150.0 x 100.0 mm, 87 parts (0 on the bottom side), 48 nets.

Other parts of the board:
U$2: BOARD
