L31N/lsd/(commit log)

2018-09-28 added datasheet for power mosfet motor driver
2018-09-28 added lsd library added schematic for display board -> containing connector, atmega8, rs232, buttons
    [display.sch]
2018-09-28 first complete schematic version
    [display.brd, display.sch]
2018-09-28 changed resistor packages on sheet 1
    [display.brd, display.sch]
2018-09-28 exported schematic as PDF
    [display.brd]
2018-09-30 added Leistungsschaltplan
    [leistung.sch]
2018-10-01 added values for all the parts in schematic added some datasheets
    [display.brd, display.sch]
2018-10-01 merged with regelungsplatine
    [display.ods, display.sch, regelschaltplan.brd, regelschaltplan.sch]
2018-10-01 edit device lf33ab to lib
2018-10-01 developed hard
    [leistung.brd, leistung.sch]
2018-10-01 added ltv844 to library
    [display.ods]
2018-10-01 added reichelt directory with the order information for display board
2018-10-01 changed naming high/low voltage area
    [leistung.brd, leistung.sch]
2018-10-01 added frames to display schematic
    [display.sch]
2018-10-01 added supply to logic gates
    [leistung.brd, leistung.sch]
2018-10-01 edit new schaltplan
    [regelschaltplan.brd, regelschaltplan.sch]
2018-10-01 merged alexs schmeatic with the one from dominik
    [leistung.brd, leistung.sch]
2018-10-01 added 5V status led to LST side
    [leistung.brd, leistung.sch]
2018-10-01 added jumper to interrupt VCC via RS232 to debug
    [display.brd, display.sch]
2018-10-01 added jumper to rs232 connector to interrupt 5V supply
    [display.brd, display.sch]
2018-10-02 moved decoupling to regelungsplatine
    [leistung.brd, leistung.sch, regelschaltplan.brd, regelschaltplan.sch]
2018-10-02 exported pdf file of the schematics
2018-10-02 replaced resistor with potentiometer in voltage devider for battery monitoring
    [leistung.brd, leistung.sch]
2018-10-02 added blocking capacitors to 3V3 supply added rs323 cross pinhead
    [regelschaltplan.brd, regelschaltplan.sch]
2018-10-02 fixed mirrored isp connector in display board
    [display.brd, display.sch, regelschaltplan.sch]
2018-10-02 exported versions for eagle 7.x.x
    [display_e7.brd, display_e7.sch, leistung_e7.brd, leistung_e7.sch, regelschaltplan_e7.brd, regelschaltplan_e7.sch]
2018-10-02 added RS232 crossing pinhead
    [display.brd, display.sch]
2018-10-02 added supply pins to max232
    [display.brd, display.sch]
2018-10-02 added blocking capacities to IO-Expanders
    [display.brd, display.sch]
2018-10-02 updated display contrast trimming circuit
    [display.brd, display.sch]
2018-10-02 added display board frame to library replaced board frame in display schematic
    [display.brd, display.sch]
2018-10-02 edit optokoppler with hpcl2621
    [regelschaltplan_e7.brd, regelschaltplan_e7.sch]
2018-10-02 added values to PCF blocking capacities
    [display.brd, display.sch]
2018-10-02 Nachbesprechung Änderungen gemacht
    [leistung.brd, leistung.sch]
2018-10-02 final changes and bestückungsliste
    [leistung.sch]
2018-10-02 fixed some bugs in schematic board file with all components placed
    [display.brd, display.sch]
2018-10-02 aktueller schaltplan
    [leistung.sch]
2018-10-02 eagle 7 export
    [leistung.brd, leistung_e7.brd, leistung_e7.sch, regelschaltplan_e7.brd, regelschaltplan_e7.sch]
2018-10-02 worked on regelschaltplan
    [regelschaltplan_e7.brd, regelschaltplan_e7.sch]
2018-10-02 exported the current version of the eagle 7 compatible file for display board
    [display_e7.brd, display_e7.sch]
2018-10-02 working on display.brd
    [display.brd]
2018-10-03 worked on board layout (ca. 80% routed) changed LEDs from GND to +5V
    [display.brd, display.sch]
2018-10-03 added npn transistors to LED bars
    [display.brd, display.sch]
2018-10-03 routed led transistors
    [display.brd]
2018-10-03 fixed wrong naming of SCL (used SDL) for IO-Expanders
    [display.sch]
2018-10-03 worked on dispaly.brd, only some airwire left
    [display.brd]
2018-10-03 finished routing there just some wire stubs to remove (DRC)
    [display.brd, display.sch]
2018-10-04 removed wire stub drc warnings, increased wire width for +5V
    [display.brd]
2018-10-04 added layer lables
    [display.brd]
2018-10-04 changed layer label size
    [display.brd]
2018-10-04 layouted H-Bridges
    [leistung.brd, leistung.sch]
2018-10-04 added pullup resistors to buttons
    [display.brd, display.sch]
2018-10-04 added values to the pullups (buttons)
    [display.brd, display.sch]
2018-10-04 changed routing of the +5V to pullups, away from pcb border
    [display.brd]
2018-10-04 edit regelungsboard-fertig
    [regelschaltplan_e7.brd, regelschaltplan_e7.sch]
2018-10-04 finalized board
    [leistung.brd, leistung.sch]
2018-10-04 saved again
    [leistung.brd]
2018-10-05 push of bennis files
    [regelung.csv]
2018-10-05 added Text on Layers for identification
    [regelschaltplan_e7.brd]
2018-10-05 added Text
    [leistung.brd, leistung.sch]
2018-10-05 saved as e7 for benni
    [regelschaltplan_e7.brd, regelschaltplan_e7.sch]
2018-10-05 edit regellayout done
    [regelschaltplan_e7.brd]
2018-10-05 updated eagle7 copatible exports of display and leistung boards
    [display_e7.brd, display_e7.sch, leistung_e7.brd, leistung_e7.sch]
2018-10-05 removed drillings from display_frame in library
    [display.brd, display.sch]
2018-10-05 fixed alle clearance error (for bigger pads (12mil))
    [display.brd]
2018-10-05 fixes aus der Nachbesprechung
    [leistung.brd, leistung_e7.brd]
2018-10-05 used isolation 20 for ground planes
    [display.brd, display_e7.brd, display_e7.sch]
2018-10-05 fixed some only top layer gnd connections
    [display.brd]
2018-10-05 exported e7 compatible files of current version
    [display.brd, display.sch]
2018-10-08 edit regelschaltplan_e7 bauteil fixed
    [regelschaltplan_e7.brd, regelschaltplan_e7.sch]
2018-10-08 updated e7 compatible version of display
    [display.brd, display.csv, display_e7.brd]
2018-10-08 exported pdf of the board files
2018-10-08 updated display.bom
